zekaizer/deskhop/src-rust/src/hal/ffi/tasks.rs

// Task scheduler entry points — called from Rust scheduler in lib.rs.
// C-called FFI exports (#[no_mangle]) are at the bottom of this file.

// --- Static state ---
// DBG_COUNT and LAST_POINTER_MOVE are touched only from Core0 scheduler tasks,
// so raw static mut access via addr_of_mut! is safe.

static mut DBG_COUNT: u32 = 0;
static mut LAST_POINTER_MOVE: u32 = 0;

// --- Passthrough state ---
//
// KNOWN RACE: PT_STATE is shared mutable state accessed from BOTH cores
// without atomic protection. Writers:
//   - Core0: passthrough_task (scheduler), rust_on_tud_set_report (TinyUSB
//     device cb)
//   - Core1: rust_on_hid_mount, rust_on_hid_umount, rust_on_hid_report_received
//     (TinyUSB host callbacks)
// Readers (Core0): rust_get_*_descriptor, pt_is_active, pt_iface_count,
// pt_upstream_vid/pid (called from TinyUSB device GET_DESCRIPTOR path).
//
// This violates ADR-0002's "no contention" invariant. Race windows are narrow
// in practice (USB enumeration is the only timing-sensitive path) and the
// failure modes (torn descriptor reads, use-after-compaction) are rare but
// real. Production fix is a Core1→Core0 mount/umount/report event queue so
// PT_STATE mutation is serialized to Core0; deferred. See CONTEXT.md
// "Flagged ambiguities".

use crate::domain::passthrough::PassthroughState;

static mut PT_STATE: PassthroughState = unsafe { core::mem::zeroed() };

/// Get mutable reference to passthrough state.
/// SAFETY: Caller must accept the cross-core race documented above.
pub(crate) unsafe fn get_pt_state() -> &'static mut PassthroughState {
    &mut *core::ptr::addr_of_mut!(PT_STATE)
}

// --- Remap engine state (Core1-serialized) ---
//
// All post-boot access runs on Core1: remap_engine_process in the TinyUSB
// host report callback (inside usb_host_task) and remap_engine_tick_task,
// both on the Core1 scheduler loop, strictly sequential. The only Core0
// access is remap_engine_init in rust_passthrough_init, which runs before
// multicore_launch_core1 (setup.c). Do not schedule users of this state on
// Core0 — that reintroduces a cross-core aliased-&mut race.

use crate::domain::key_remap::RemapEngine;

static mut REMAP_ENGINE: RemapEngine = unsafe { core::mem::zeroed() };

pub(crate) unsafe fn get_remap_engine() -> &'static mut RemapEngine {
    &mut *core::ptr::addr_of_mut!(REMAP_ENGINE)
}

// ============================================================
// Scheduler task functions (Rust ABI — called from lib.rs)
// ============================================================

pub(crate) unsafe fn kick_watchdog_task() {
    let hal = crate::hal::pico::PicoHal::new();
    let mut state = crate::domain::structs::DeviceState::from_globals();
    let state = &mut state;
    crate::service::tasks::check_system_health(state, &hal);

    use crate::hal::traits::Trace;
    let count = &mut *core::ptr::addr_of_mut!(DBG_COUNT);
    *count += 1;
    if *count >= 150 {
        *count = 0;
        hal.dump_state();
    }
}

pub(crate) unsafe fn heartbeat_output_task() {
    let hal = crate::hal::pico::PicoHal::new();
    let state = crate::domain::structs::DeviceState::from_globals();
    crate::service::tasks::heartbeat_tick(&state, &hal);
}

pub(crate) unsafe fn packet_receiver_task() {
    let hal = crate::hal::pico::PicoHal::new();
    let mut state = crate::domain::structs::DeviceState::from_globals();
    crate::service::tasks::packet_receive_tick(&mut state, &hal);
}

// Core0 only (device-side scheduler task).
static mut HID_QUEUE_STALL: crate::service::tasks::HeadStall =
    crate::service::tasks::HeadStall::new();

pub(crate) unsafe fn process_hid_queue_task() {
    let hal = crate::hal::pico::PicoHal::new();
    let stall = &mut *core::ptr::addr_of_mut!(HID_QUEUE_STALL);
    crate::service::tasks::process_hid_queue(&hal, stall, crate::hal::device::hal_time_us_32());
}

pub(crate) unsafe fn led_blinking_task() {
    let hal = crate::hal::pico::PicoHal::new();
    let mut state = crate::domain::structs::DeviceState::from_globals();
    crate::service::tasks::led_blink_tick(&mut state, &hal);
}

/// Re-send the keyboard LED state until the keyboard accepts it. Core1 only:
/// send_kbd_leds_xcore reaches tuh_hid_set_report directly on this core.
pub(crate) unsafe fn led_sync_task() {
    let cfg = &*core::ptr::addr_of!(crate::domain::structs::GLOBAL_CFG);
    if let Some(desired) = crate::service::led::led_sync_needed(cfg) {
        let hid = &*core::ptr::addr_of!(crate::domain::structs::GLOBAL_HID);
        crate::hal::ffi::callbacks::send_kbd_leds_xcore(
            hid.kbd_dev_addr, hid.kbd_instance, &desired, 1,
        );
    }
}

pub(crate) unsafe fn screensaver_task() {
    let hal = crate::hal::pico::PicoHal::new();
    let mut state = crate::domain::structs::DeviceState::from_globals();
    let state = &mut state;

    let mut report_bytes = [0u8; 8];
    let role = state.cfg.board_role as usize;
    if role < state.cfg.config.output.len() {
        match state.cfg.config.output[role].screensaver.mode {
            1 => super::util::rust_screensaver_pong(report_bytes.as_mut_ptr()),
            2 => super::util::rust_screensaver_jitter(report_bytes.as_mut_ptr()),
            _ => {}
        }
    }

    let last_move = &mut *core::ptr::addr_of_mut!(LAST_POINTER_MOVE);
    if let Some(t) = crate::service::tasks::screensaver_tick(state, &hal, *last_move, &report_bytes) {
        *last_move = t;
    }
}

/// Stamp HID activity for the board-LED flicker. Called on the active board when
/// it actually sends a report to its host — so the ACTIVE board flickers even
/// when the dongle/receiver is on the other board (reports arrive via UART).
unsafe fn mark_hid_activity() {
    let cfg = &mut *core::ptr::addr_of_mut!(crate::domain::structs::GLOBAL_CFG);
    cfg.last_hid_activity_us = crate::hal::device::hal_time_us_32();
}

pub(crate) unsafe fn process_kbd_queue_task() {
    let hal = crate::hal::pico::PicoHal::new();
    let state = crate::domain::structs::DeviceState::from_globals();
    if crate::service::backend::host_link::send_pending_kbd(&state, &hal) {
        mark_hid_activity();
    }
}

pub(crate) unsafe fn process_mouse_queue_task() {
    let hal = crate::hal::pico::PicoHal::new();
    let state = crate::domain::structs::DeviceState::from_globals();
    if crate::service::backend::host_link::send_pending_mouse(&state, &hal) {
        mark_hid_activity();
    }
}

pub(crate) unsafe fn process_uart_tx_task() {
    let hal = crate::hal::pico::PicoHal::new();
    crate::service::tasks::flush_outbox(&hal);
}

pub(crate) unsafe fn debug_log_flush_task() {
    crate::service::peer_log::debug_log_flush_task();
}

pub(crate) unsafe fn passthrough_task() {
    let hal = crate::hal::pico::PicoHal::new();
    let mut state = crate::domain::structs::DeviceState::from_globals();
    let pt = get_pt_state();
    crate::service::passthrough_service::passthrough_task(pt, &mut state, &hal);
}

/// Core1 task: flush the pending HID++ output report to the upstream device.
/// Runs on Core1 so the host control transfer is serialized with tuh_task;
/// see passthrough_service::flush_output_report for why this must not be Core0.
pub(crate) unsafe fn passthrough_host_tx_task() {
    let hal = crate::hal::pico::PicoHal::new();
    let pt = get_pt_state();
    crate::service::passthrough_service::flush_output_report(pt, &hal);
}

pub(crate) unsafe fn remap_engine_tick_task() {
    let hal = crate::hal::pico::PicoHal::new();
    let mut state = crate::domain::structs::DeviceState::from_globals();
    let state = &mut state;
    use crate::hal::traits::Timer;
    let now = hal.now_us_64();
    let engine = get_remap_engine();
    use crate::domain::key_remap;
    let hold_entered = key_remap::remap_engine_tick(engine, now);

    let mut pending = crate::domain::structs::HidKeyboardReport::default();
    if key_remap::remap_engine_get_pending(engine, &mut pending) {
        let mut tap_press = crate::domain::kbd_state::combine_kbd_states(state);
        for k in tap_press.keycode.iter_mut() {
            if *k == 0 {
                *k = pending.keycode[0];
                break;
            }
        }
        tap_press.modifier |= pending.modifier;
        use crate::service::router::ReportRouter;
        let report_bytes: [u8; 8] = core::mem::transmute(tap_press);
        hal.route_kbd(state, &report_bytes);
        let release = crate::domain::kbd_state::combine_kbd_states(state);
        let release_bytes: [u8; 8] = core::mem::transmute(release);
        hal.route_kbd(state, &release_bytes);
    }

    if hold_entered {
        // Inject the hold-action keys (e.g. CapsLock) of entries that just
        // entered Held — without this the hold produces nothing on the host.
        let mut combined = crate::domain::kbd_state::combine_kbd_states(state);
        let mut hold = crate::domain::structs::HidKeyboardReport::default();
        key_remap::remap_engine_get_active_output(engine, &mut hold);
        for &hk in hold.keycode.iter() {
            if hk == 0 {
                continue;
            }
            for k in combined.keycode.iter_mut() {
                if *k == 0 {
                    *k = hk;
                    break;
                }
            }
        }
        combined.modifier |= hold.modifier;
        use crate::service::router::ReportRouter;
        let bytes: [u8; 8] = core::mem::transmute(combined);
        hal.route_kbd(state, &bytes);
    }
}

// ============================================================
// C-callable FFI exports (#[no_mangle] / #[export_name])
// ============================================================

/// Called from C initial_setup to init remap engine + apply gaming_mode_default.
#[no_mangle]
pub unsafe extern "C" fn rust_passthrough_init() {
    let state = crate::domain::structs::DeviceState::from_globals();
    let os_a = state.cfg.config.output[0].os;
    let os_b = state.cfg.config.output[1].os;
    let engine = get_remap_engine();
    crate::domain::key_remap::remap_engine_init(engine, os_a, os_b);
    let cfg = &mut *core::ptr::addr_of_mut!(crate::domain::structs::GLOBAL_CFG);
    cfg.gaming_mode = cfg.config.gaming_mode_default != 0;
}

// --- FW auto-sync stall recovery (Core1 only: fw-upgrade receiver task) ---

use crate::service::fw_upgrade::{StallAction, StallTracker};

static mut FW_STALL: StallTracker = StallTracker::new();

/// Called from firmware_upgrade_task_c while waiting for a ResponseByte
/// (`upgrade_in_progress && !byte_done`). Returns nonzero when the caller
/// should re-send the RequestByte for the current address. An abort is
/// applied here (clears upgrade_in_progress) so heartbeats resume and the
/// peer restarts the sync from scratch.
#[no_mangle]
pub unsafe extern "C" fn rust_fw_stall_tick() -> u32 {
    let tracker = &mut *core::ptr::addr_of_mut!(FW_STALL);
    let state = crate::domain::structs::DeviceState::from_globals();
    let address = state.fw.fw.address;
    let now = crate::hal::device::hal_time_us_32();
    match crate::service::fw_upgrade::stall_tick(tracker, address, now) {
        StallAction::None => 0,
        StallAction::Resend => {
            crate::service::dlog::w(b"fw")
                .s(b"rx stall resend addr=").u(address).done();
            1
        }
        StallAction::Abort => {
            crate::service::dlog::e(b"fw")
                .s(b"rx stall ABORT addr=").u(address).done();
            state.fw.fw.upgrade_in_progress = false;
            state.fw.fw.address = 0;
            0
        }
    }
}

/// Called from C set_active_output / Rust callbacks.
#[export_name = "release_all_keys"]
pub unsafe extern "C" fn rust_release_all_keys() {
    let hal = crate::hal::pico::PicoHal::new();
    let mut state = crate::domain::structs::DeviceState::from_globals();
    crate::service::backend::host_link::release_all_keys(&mut state, &hal);
}

// --- Passthrough state accessors for C (usb_descriptors.c) ---

#[no_mangle]
pub unsafe extern "C" fn pt_is_active() -> bool {
    (*core::ptr::addr_of!(PT_STATE)).active
}

#[no_mangle]
pub unsafe extern "C" fn pt_iface_count() -> u8 {
    (*core::ptr::addr_of!(PT_STATE)).iface_count
}

#[no_mangle]
pub unsafe extern "C" fn pt_upstream_vid() -> u16 {
    (*core::ptr::addr_of!(PT_STATE)).upstream_vid
}

#[no_mangle]
pub unsafe extern "C" fn pt_upstream_pid() -> u16 {
    (*core::ptr::addr_of!(PT_STATE)).upstream_pid
}

#[no_mangle]
pub unsafe extern "C" fn pt_config_desc(out_len: *mut u16) -> *const u8 {
    let (ptr, len) = super::pt_config_desc_ptr();
    if !out_len.is_null() { *out_len = len; }
    ptr
}

#[no_mangle]
pub unsafe extern "C" fn pt_get_report_desc(device_instance: u8, out_len: *mut u16) -> *const u8 {
    let pt = &*core::ptr::addr_of!(PT_STATE);
    match crate::domain::passthrough::get_report_desc(pt, device_instance) {
        Some((desc, len)) => {
            if !out_len.is_null() { *out_len = len; }
            desc.as_ptr()
        }
        None => core::ptr::null(),
    }
}

// pt_iface_protocol / pt_iface_desc_len (C accessors for the old C descriptor
// builder) were removed: the builder is now Rust (domain::usb_config_desc) and
// reads PT_STATE directly via get_pt_state.
