zekaizer/deskhop/src-rust/src/domain/keyboard.rs

use crate::domain::structs::HidKeyboardReport;

/// What action to perform when a hotkey matches
#[derive(Debug, Clone, Copy, PartialEq, Eq)]
pub enum HotkeyAction {
    OutputToggle,
    MouseZoomToggle,
    SwitchLockToggle,
    ScreenLock,
    GamingModeToggle,
    ScreensaverPong,
    ScreensaverJitter,
    ScreensaverDisable,
    WipeConfig,
    ScreenBorder,
    ConfigEnable,
    FwUpgradeA,
    FwUpgradeB,
}

impl HotkeyAction {
    /// Short name for debug logging.
    pub const fn name(&self) -> &'static [u8] {
        match self {
            Self::OutputToggle => b"OutputToggle",
            Self::MouseZoomToggle => b"MouseZoomToggle",
            Self::SwitchLockToggle => b"SwitchLockToggle",
            Self::ScreenLock => b"ScreenLock",
            Self::GamingModeToggle => b"GamingModeToggle",
            Self::ScreensaverPong => b"ScreensaverPong",
            Self::ScreensaverJitter => b"ScreensaverJitter",
            Self::ScreensaverDisable => b"ScreensaverDisable",
            Self::WipeConfig => b"WipeConfig",
            Self::ScreenBorder => b"ScreenBorder",
            Self::ConfigEnable => b"ConfigEnable",
            Self::FwUpgradeA => b"FwUpgradeA",
            Self::FwUpgradeB => b"FwUpgradeB",
        }
    }
}

/// Hotkey definition for matching keyboard combos
pub struct HotkeyCombo {
    pub modifier: u8,
    pub keys: &'static [u8],
    pub pass_to_os: bool,
    pub acknowledge: bool,
    pub action: HotkeyAction,
}

/// Result of check_all_hotkeys
pub struct HotkeyMatch {
    pub action: HotkeyAction,
    pub pass_to_os: bool,
    pub acknowledge: bool,
}

/// Check all hotkeys against a report. Returns first match.
pub fn check_all_hotkeys(report: &HidKeyboardReport) -> Option<HotkeyMatch> {
    use crate::domain::constants::*;

    static HOTKEYS: &[HotkeyCombo] = &[
        HotkeyCombo { modifier: HOTKEY_MODIFIER, keys: &[HOTKEY_TOGGLE], pass_to_os: false, acknowledge: false, action: HotkeyAction::OutputToggle },
        HotkeyCombo { modifier: KEYBOARD_MODIFIER_RIGHTALT | KEYBOARD_MODIFIER_RIGHTCTRL, keys: &[], pass_to_os: true, acknowledge: true, action: HotkeyAction::MouseZoomToggle },
        HotkeyCombo { modifier: KEYBOARD_MODIFIER_RIGHTCTRL, keys: &[HID_KEY_K], pass_to_os: false, acknowledge: true, action: HotkeyAction::SwitchLockToggle },
        HotkeyCombo { modifier: KEYBOARD_MODIFIER_RIGHTCTRL, keys: &[HID_KEY_L], pass_to_os: false, acknowledge: true, action: HotkeyAction::ScreenLock },
        HotkeyCombo { modifier: KEYBOARD_MODIFIER_LEFTCTRL | KEYBOARD_MODIFIER_RIGHTSHIFT, keys: &[HID_KEY_G], pass_to_os: false, acknowledge: true, action: HotkeyAction::GamingModeToggle },
        HotkeyCombo { modifier: KEYBOARD_MODIFIER_LEFTCTRL | KEYBOARD_MODIFIER_RIGHTSHIFT, keys: &[HID_KEY_S], pass_to_os: false, acknowledge: true, action: HotkeyAction::ScreensaverPong },
        HotkeyCombo { modifier: KEYBOARD_MODIFIER_LEFTCTRL | KEYBOARD_MODIFIER_RIGHTSHIFT, keys: &[HID_KEY_J], pass_to_os: false, acknowledge: true, action: HotkeyAction::ScreensaverJitter },
        HotkeyCombo { modifier: KEYBOARD_MODIFIER_LEFTCTRL | KEYBOARD_MODIFIER_RIGHTSHIFT, keys: &[HID_KEY_X], pass_to_os: false, acknowledge: true, action: HotkeyAction::ScreensaverDisable },
        HotkeyCombo { modifier: KEYBOARD_MODIFIER_RIGHTSHIFT, keys: &[HID_KEY_F12, HID_KEY_D], pass_to_os: false, acknowledge: true, action: HotkeyAction::WipeConfig },
        HotkeyCombo { modifier: KEYBOARD_MODIFIER_RIGHTSHIFT, keys: &[HID_KEY_F12, HID_KEY_Y], pass_to_os: false, acknowledge: true, action: HotkeyAction::ScreenBorder },
        HotkeyCombo { modifier: KEYBOARD_MODIFIER_LEFTCTRL | KEYBOARD_MODIFIER_RIGHTSHIFT, keys: &[HID_KEY_C, HID_KEY_O], pass_to_os: false, acknowledge: true, action: HotkeyAction::ConfigEnable },
        HotkeyCombo { modifier: KEYBOARD_MODIFIER_RIGHTSHIFT | KEYBOARD_MODIFIER_LEFTSHIFT, keys: &[HID_KEY_A], pass_to_os: false, acknowledge: true, action: HotkeyAction::FwUpgradeA },
        HotkeyCombo { modifier: KEYBOARD_MODIFIER_RIGHTSHIFT | KEYBOARD_MODIFIER_LEFTSHIFT, keys: &[HID_KEY_B], pass_to_os: false, acknowledge: true, action: HotkeyAction::FwUpgradeB },
    ];

    for hotkey in HOTKEYS {
        if check_specific_hotkey(hotkey, report) {
            return Some(HotkeyMatch {
                action: hotkey.action,
                pass_to_os: hotkey.pass_to_os,
                acknowledge: hotkey.acknowledge,
            });
        }
    }
    None
}

/// Check if a key exists in a keyboard report.
// WORKAROUND(c-compat): Matches C behavior where key=0x00 returns true
// because empty slots contain 0x00. Could filter key==0 in the future.
pub fn key_in_report(key: u8, report: &HidKeyboardReport) -> bool {
    report.keycode.contains(&key)
}

/// Check if a keyboard report matches a specific hotkey combo
pub fn check_specific_hotkey(hotkey: &HotkeyCombo, report: &HidKeyboardReport) -> bool {
    // All specified modifiers must be present
    if hotkey.modifier != (report.modifier & hotkey.modifier) {
        return false;
    }

    // All specified keys must be present
    hotkey.keys.iter().all(|&key| key_in_report(key, report))
}

/// Add keys from src to dest, skipping zeros and duplicates.
/// Returns how many keys were added.
pub fn add_keys(dest: &mut HidKeyboardReport, src: &HidKeyboardReport) -> usize {
    let mut added = 0;

    for &key in &src.keycode {
        if key == 0 || key_in_report(key, dest) {
            continue;
        }

        // Find first empty slot
        if let Some(slot) = dest.keycode.iter_mut().find(|k| **k == 0) {
            *slot = key;
            added += 1;
        }
    }

    added
}

/// Combine multiple keyboard reports into one, merging modifiers and keys.
pub fn combine_reports(reports: &[HidKeyboardReport]) -> HidKeyboardReport {
    let mut combined = HidKeyboardReport::default();

    for report in reports {
        combined.modifier |= report.modifier;
        add_keys(&mut combined, report);
    }

    combined
}
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
