zekaizer/deskhop/(commit log)

2026-03-18 test: add Unity framework and placeholder test
2026-03-18 ci(test): add unit test workflow with Unity framework
2026-03-18 feat(passthrough): hook descriptor capture into mount callback
2026-03-18 fix(passthrough): add missing passthrough_get_state declaration
    [passthrough.h]
2026-03-18 fix(passthrough): add unmount cleanup and duplicate capture prevention
    [passthrough.c, passthrough.h, usb.c]
2026-03-18 refactor(passthrough): cache passthrough_get_state() in mount callback
2026-03-19 docs: add Bolt receiver HID descriptor capture from real hardware
    Captured via passthrough_dump_descriptors() on DeskHop PCB v1.1.
    Documents all 3 interfaces (Keyboard, Mouse, HID++ Vendor) with
    parsed field descriptions and report ID mappings.
2026-03-19 docs(spec): add conditional VID/PID switching design (FR-PT-009, FR-PT-010)
    TECHSTACK: add VID/PID switching flow to Phase 2 passthrough design.
    SSR: add FR-PT-009 (upstream VID/PID exposure) and FR-PT-010 (unmount
    revert). Update FR-PT-005 acceptance criteria for Options+ recognition.
2026-03-19 feat(passthrough): add device-side descriptor generation and instance mapping
    Build dynamic USB configuration descriptor combining DeskHop's own
    interfaces (ITF 0-1) with passthrough interfaces captured from the host
    device. Includes host↔device instance mapping for report routing and
    modified TinyUSB callbacks to serve passthrough descriptors.
2026-03-19 feat(passthrough): add raw report forwarding for passthrough interfaces
    Forward non-keyboard input reports from host receiver to device-side
    passthrough interfaces (mouse raw, vendor/HID++). Forward output reports
    (SET_REPORT from Win11/Options+) back to the host receiver. Keyboard
    reports continue through DeskHop's parsing pipeline for hotkey detection.
2026-03-19 feat(passthrough): add re-enumeration task for passthrough activation
    Add periodic passthrough_task on core0 that detects when host descriptor
    capture stabilizes (500ms after last capture), builds the device-side
    configuration descriptor, and triggers USB re-enumeration via
    tud_disconnect/tud_connect with 200ms delay per USB spec.
2026-03-19 fix(debug): add timestamps and reduce log noise
    - Prepend [ms] timestamp to all dh_debug_printf output
    - Only log HID++ vendor IN reports (skip high-frequency mouse)
    - Add passthrough task lifecycle logs (activate/disconnect/reconnect)
    [tasks.c, usb.c]
2026-03-19 feat(passthrough): conditional VID/PID switching for Options+ (FR-PT-009)
    - Capture upstream VID/PID via tuh_vid_pid_get() on mount
    - Return upstream VID/PID in tud_descriptor_device_cb() when active
    - Override manufacturer/product strings for Logitech VID (0x046D)
    - Clear VID/PID and re-enumerate on unmount (FR-PT-010)
    - Add unit tests for VID/PID capture, clear, and retention
2026-03-19 feat(passthrough): deferred HID++ output via raw SET_REPORT
    Queue HID++ output reports from device callback and send via
    tuh_control_xfer in passthrough_task. Logitech receivers require
    full report (report_id + payload) in the data phase with wLength
    matching the full report size, not TinyUSB's default behavior.
2026-03-19 fix(passthrough): always re-queue receive for always_passthrough interfaces
    HID++ vendor interface must call tuh_hid_receive_report() regardless
    of active output, otherwise IN reports stop after the first few.
    Also queue output reports for deferred send instead of direct
    tuh_hid_set_report from callback, and add debug logging.
    [usb.c]
2026-03-19 docs: add HID++ output report protocol analysis
    Documents SET_REPORT wire format for Logitech receivers, Linux kernel
    driver behavior, and the wLength=7 requirement discovered during
    real hardware testing.
2026-03-19 feat(passthrough): classify HID++ messages by sw_id, drop input events on inactive output
    HID++ vendor interface (always_passthrough) now routes by message type:
    - sw_id != 0: protocol response → always forward to device side (Options+)
    - sw_id == 0: unsolicited input event → forward only to active output
    - B active: input events dropped (P3 will convert to standard HID via UART)
    Fixes issue where HiRes scroll and side buttons acted on output A when B was active.
    [passthrough.c, passthrough.h, usb.c]
2026-03-19 refactor(passthrough): address code review findings
    - Fix potential buffer overflow: MAX_CONFIG_DESC_SIZE 256→280 + bounds check
    - Remove epout probe that sent dummy data to device on mount
    - Delegate to TUD_HID_DESCRIPTOR / TUD_CDC_DESCRIPTOR macros instead of
    manual byte construction (eliminates drift risk, -80 lines)
    - Remove duplicate VID/PID clearing in tuh_hid_umount_cb
    - Replace magic 0x09 with HID_REQ_CONTROL_SET_REPORT constant
    - Consolidate triplicated tuh_hid_receive_report into single call site
    - Guard hex dump in tud_hid_set_report_cb with #ifdef DH_DEBUG
    [passthrough.h, tasks.c, usb.c]
2026-03-19 docs(spec): reflect P2 HID++ discoveries in TECHSTACK and SSR
    TECHSTACK.md:
    - §3.2: routing table split HID++ vendor into protocol (sw_id≠0) vs
    input events (sw_id=0), update Android-mode diagram with sw_id branch
    - §3.2: output report path corrected to tuh_control_xfer (not
    tuh_hid_set_report which STALLs on Logitech receivers)
    - §3.3: passthrough_state_t updated to match actual implementation
    (out_queue, VID/PID, config_desc, timestamps)
    - §3.4 Phase 3: replaced planned design with actual implementation
    results, add HID++ message structure and feature index table
    SSR.md:
    - FR-AO-004: add sw_id classification to routing description
    - Appendix A.1: update data structures to ma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
2026-03-20 chore: add clangd setup for cross-compilation IDE support
    - .clangd config with diagnostics settings
    - .vscode/settings.json with --query-driver for arm-none-eabi
    - .gitignore: compile_commands.json, .cache
2026-03-20 feat(passthrough): IRoot feature discovery and HID++ to mouse conversion
    IRoot Discovery Engine:
    - State machine in passthrough_task: IDLE → DETECT_DEVICE →
    QUERY_HIRES_SCROLL → QUERY_THUMBWHEEL → DONE
    - Detects HID++ device index from first vendor interface traffic
    - Sends IRoot queries via out_queue (sw_id=0x0F)
    - Intercepts responses, caches feature indices; 2s timeout per query
    HID++ → mouse_report_t Conversion:
    - Replaces silent drop with mouse report conversion on inactive output
    - HiRes Scroll (0x2121) → wheel, Thumbwheel (0x2150) → pan
    - Uses output_mouse_report() for automatic UART relay
    - Unknown features still dropped gracefully
    Tests: IRoot response parsing, HiR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
    [passthrough.c, passthrough.h, tasks.c, usb.c]
2026-03-20 wip(passthrough): HID++ button conversion, auto-learn, debug tools
    - Auto-learn ReprogControls feature index from observed events (bypass IRoot)
    - analyticsKeyEvent (fn=2) parsing with button state tracking
    - Merge HID++ button_state into output_mouse_report (B active only)
    - Immediate button report with cursor position on state change
    - Clear passthrough state on device disconnect (active, button_state)
    - Clear button_state on output switch
    - HID++ protocol scan hotkey (LeftCtrl+RightShift+H+P)
    - Pipeline debug hotkey (LeftCtrl+RightShift+P+D) with P1-P5 trace
    - Raw HID++ event hex dump toggle
    - BOOTSEL short press output switch (core1→core0 flag)
    NOTE: Button click not yet functional on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
    [passthrough.c, passthrough.h, pinout.h, structs.h, tasks.c, usb.c]
2026-03-20 fix(passthrough): P3 immediate button report respects gaming/relative mode
    The HID++ button-change immediate report (P3) was hardcoded to ABSOLUTE
    mode, causing two issues:
    1. In gaming mode, buttons were sent to Interface 0 (ABS) while movement
    went to Interface 1 (REL), resulting in duplicate button delivery on
    both USB interfaces.
    2. In relative mode, absolute pointer coordinates were sent as relative
    deltas, causing cursor teleportation on button press/release.
    Fix: check gaming_mode/relative_mouse and set mode accordingly. In
    relative mode, send zero coordinates (button-only, no movement).
    [usb.c]
2026-03-20 chore: reduce verbose passthrough debug logs
    Suppress high-frequency success logs for OUT raw xfer and SET_REPORT
    callbacks. Only log on failure to keep CDC debug output readable.
    [tasks.c]
2026-03-20 docs: add HID++ protocol analysis for Bolt receiver
    Add observed feature index map, button CIDs, HiResScroll/Thumbwheel
    event formats, and Options+ impact analysis captured from debug logs.
    Documents the root cause of wheel loss after Options+ detection.
2026-03-20 fix(passthrough): HID++ wheel conversion mode and struct packing
    Fix two bugs preventing HiResScroll/Thumbwheel HID++ events from
    reaching Android after Options+ diverts wheel reporting to HID++:
    1. passthrough_mouse_report_t missing TU_ATTR_PACKED — struct padding
    mismatch with mouse_report_t caused wheel/pan values to be written
    at wrong offsets (offset 6 vs expected 5 on ARM).
    2. Converted wheel reports sent with mode=ABSOLUTE (default 0) instead
    of RELATIVE — Android ignores ABSOLUTE interface when gaming_mode
    is active. Now matches button conversion which correctly sets mode.
    [passthrough.c, usb.c]
2026-03-20 feat(passthrough): passive HID++ feature discovery via host command sniffing
    Instead of sending IRoot queries (which compete with Options+ for the
    out_queue), sniff the host's own setup commands as they pass through:
    - HiResScroll: detected from setWheelMode(fn=2, param=0x03) signature
    - Thumbwheel: detected from setReporting(fn=2, param=0x01) with
    same-device guard to prevent false positives
    Options+ uses FeatureSet (not IRoot) for enumeration, making our
    previous IRoot-based passive sniffing ineffective. The command
    signature approach works regardless of discovery protocol used by
    the host software.
    [passthrough.h, usb.c]
2026-03-20 feat(passthrough): discovery-first connect with LED status indication
    Defer tud_connect() until passthrough descriptor is ready, eliminating
    the disconnect/reconnect cycle that caused a brief device "blink" on
    the host side.
    Boot flow: tud_init() → tud_disconnect() → wait for descriptor
    capture → passthrough_activate() → tud_connect() (single connect).
    Fallback: 3s timeout with no receiver → connect with defaults.
    LED slow pulse (50ms on / 450ms off) indicates passthrough preparation
    in progress, distinct from config mode's fast burst pattern.
2026-03-20 chore: remove verbose passthrough descriptor dump on mount
    The per-interface hex dump fired on every tuh_hid_mount_cb() call,
    producing 3 large log blocks for each Bolt receiver enumeration.
    No longer needed after passthrough stabilization.
    [usb.c]
2026-03-20 fix(passthrough): unconditionally set device_idx on setWheelMode sniff
    setWheelMode(0x03) is unique to HiResScroll and definitively identifies
    the mouse device. Always update device_idx instead of only when zero,
    fixing Thumbwheel false positive when active IRoot discovery previously
    set device_idx to the keyboard.
    [usb.c]
2026-03-20 refactor(passthrough): remove active IRoot discovery in favor of passive sniffing
    Active IRoot queries competed with Options+ for the single-entry
    out_queue and incorrectly set device_idx to the keyboard. Passive
    sniffing of host setup commands (setWheelMode, setReporting) is
    reliable and zero-cost.
2026-03-20 fix(passthrough): skip passthrough in config mode to prevent ITF collision
    ITF_NUM_PT_BASE and ITF_NUM_HID_VENDOR are both 2, causing passthrough
    to intercept config mode's vendor HID SET_REPORT and INPUT forwarding.
    Fix: skip passthrough_task() entirely in config mode, and add safety
    guards on both SET_REPORT and INPUT passthrough entry points.
    [setup.c, tasks.c, usb.c]
2026-03-20 chore: remove dead IRoot discovery code, clean up structs
    Remove active IRoot discovery functions and state (replaced by passive
    sniffing in 16df064). Clean up:
    - passthrough.h: remove DISC_* enum values, state/query_sent_us fields,
    send/handle/step function declarations, unused HIDPP_DISC_TIMEOUT_US
    - passthrough.c: remove ~120 lines of IRoot query/response/step code
    - passthrough.c: reset all fi_* fields on device removal
    - structs.h: move LED_BLINK defines outside struct body
    - tests: remove test_iroot_response_parsing, update remaining tests
    [passthrough.c, passthrough.h, structs.h, usb.c]
2026-03-20 fix(passthrough): normalize HiRes scroll speed with accumulator
    HiRes mode: ~6-7 events/notch × delta~2 = ~12-14 total per notch.
    Normal mode: 1 event × delta=1 = 1 per notch.
    Accumulate HiRes deltas and divide by 12 to normalize to standard
    wheel behavior. Applies to both vertical and horizontal scroll.
    [passthrough.c, passthrough.h]
2026-03-20 feat(passthrough): SmartShift button (CID 0xC4) as A/B output switch
    Intercept HID++ analyticsKeyEvent for CID 0x00C4 before output routing,
    so it works regardless of which output is active. Event is forwarded
    (not consumed) to keep Options+ in sync.
    Ratchet mode is managed via Options+ SmartShift button assignment
    (set to "None" to prevent physical toggle).
    [passthrough.c, structs.h, tasks.c, usb.c]
2026-03-20 feat(remap): integrate remap engine into firmware
    Add remap_engine to device_t, hook into keyboard callback,
    add 1ms tick task for tap-hold timeout.
2026-03-20 fix(remap): correct keyboard pipeline ordering for remap engine
    The remap engine was not effective because:
    1. remap_engine_init() was never called at boot
    2. send_key() uses combine_kbd_states() which reads cached keyboard
    state — remap modified the report but not the cache
    Fix pipeline ordering:
    extract → update_state → check_hotkeys (original keys)
    → remap → update_state again (remapped keys) → send_key
    Hotkeys match on original physical keys (e.g., Ctrl+CapsLock),
    while the host receives remapped keys (e.g., LShift+Space).
    [setup.c]
2026-03-21 feat(remap): require double-click on SmartShift for output switch
2026-03-22 fix(remap): deliver TAP_HOLD tap and hold actions to host
    send_key() ignores its report argument and always uses
    combine_kbd_states(), which only combines local_kbd_states.
    TAP_HOLD removes the trigger from reports, so neither tap
    (via get_pending) nor hold actions ever reached the host.
    - Add remap_engine_get_active_output() to expose RS_HELD keys
    - Include active output in combine_kbd_states() for hold delivery
    - Route tap actions directly via route_kbd_report() helper
    - Return bool from remap_engine_tick() to trigger hold send
    - Update tick_task to send combined report on hold transition
    [key_remap.c, key_remap.h, tasks.c]
2026-03-22 feat(remap): skip CapsLock TAP_HOLD on macOS outputs
    macOS handles CapsLock → 한영 natively, so applying the
    TAP_HOLD remap causes double-switching. Use OUTPUT_A_OS /
    OUTPUT_B_OS config to compute output_mask at init time,
    excluding macOS outputs from the default CapsLock entry.
    - Add os_a/os_b params to remap_engine_init()
    - Pass runtime config values from setup.c
    - Add os_type_e mirror enum for unit test builds
    [key_remap.c, key_remap.h, setup.c]
2026-03-22 chore(remap): increase TAP_HOLD default threshold to 250ms
    200ms felt too short for comfortable tap-vs-hold distinction.
    [key_remap.h]
2026-03-22 feat(config): gate passthrough on PASSTHROUGH_ENABLED flag
    Skip descriptor capture and passthrough activation when
    PASSTHROUGH_ENABLED=0. BOOTSEL and SmartShift button handling
    remain active regardless. Logitech receivers (Bolt/Unifying)
    auto-detected by VID when enabled.
    [tasks.c, usb.c]
2026-03-22 feat(config): add Semi-DDM fields to config_t for runtime settings
    Add passthrough_enabled, gaming_mode_default, and
    smartshift_double_click_us to config_t with flash persistence.
    Bump CURRENT_CONFIG_VERSION to 9. Replace compile-time macros
    with runtime config references in tasks.c, usb.c, and setup.c.
    Add api_field_map entries (90-92) for webconfig access.
    [config.h, setup.c, structs.h, tasks.c, usb.c]
2026-03-22 refactor(config): change SmartShift threshold unit from μs to ms
    More intuitive for webconfig UI. Config stores milliseconds,
    firmware converts to μs at comparison time (× 1000).
2026-03-22 docs: update CLAUDE.md with webconfig build pipeline and receiver info
    Add webconfig section documenting the full build pipeline
    (form.py → render.py → config.htm → disk.img → firmware),
    including sudo-free Python FAT12 image generator and
    step-by-step guide for adding new config fields.
    Update receiver info to include Unifying support.
2026-03-22 Add rust_main_loop() FFI call in main.c
    Call the Rust entry point after initial_setup(). Currently a no-op
    stub that returns immediately, so no behavioral change.
    Verified: rust_main_loop symbol linked at 0x2000ef8c.
2026-03-22 Add trace macro infrastructure with feature-gated UART output
    trace!() and traceln!() macros write raw bytes to UART via C HAL
    shim when `trace` feature is enabled. Compiles to zero code in
    release builds without the feature. DH_DEBUG integration to follow.
2026-03-22 Port UART packet struct and serialization to Rust
    Add packet module with UartPacket struct, write_raw_packet(),
    parse_raw_packet(), checksum verification, and ring buffer pointer
    delta calculation. 6 unit tests covering roundtrip, bad preamble,
    checksum, and data accessors.
2026-03-22 Port mouse coordinate math and acceleration to Rust
    Add mouse module with move_and_keep_on_screen(), screen switch
    detection, acceleration factor calculation (alpha-max-beta-min
    instead of sqrtf to avoid libm), and Y-coordinate scaling for
    cross-screen transitions. 12 unit tests.
    [lib.rs, mouse.rs]
2026-03-22 Port keyboard hotkey matching and report merging to Rust
    Add keyboard module with KeyboardReport struct, key_in_report(),
    check_specific_hotkey(), add_keys() with dedup, and
    combine_reports() for multi-device keyboard state merging.
    9 unit tests covering hotkey matching, modifier handling, key
    dedup, overflow, and report combination.
2026-03-22 Annotate C-compat workarounds with WORKAROUND(c-compat) comments
    Mark 5 locations where Rust code intentionally matches C behavior
    for compatibility: key_in_report 0x00 matching, i32 return instead
    of enum, alpha-max-beta-min sqrt approximation, repr(C,packed)
    packet layout, and 1-bit sign extension semantics.
    [hid_report.rs, keyboard.rs, mouse.rs, packet.rs]
2026-03-22 Add device_t opaque handle and C HAL shim layer
    Introduce DeviceHandle as an opaque pointer to C's device_t,
    with extern "C" getter/setter functions for safe FFI access.
    Add hal_shim.c implementing all accessors (state, config, flags,
    queues, hardware). This avoids mirroring the full device_t layout
    in Rust while providing type-safe access to its fields.
    Also adds hal_trace_write() for Rust trace macro UART output.
    [device.rs, hal_shim.c, lib.rs]
2026-03-22 Activate Rust core0 main loop scheduler
    Replace C's core0 while(true) task loop with Rust's
    rust_main_loop(). The function now takes a device_t* and never
    returns. Task scheduling is identical: same 6 tasks at same
    frequencies. C main() now calls rust_main_loop(device) after
    initial_setup().
    Core1 main loop remains in C (core1_main).
    [lib.rs, main.c]
2026-03-22 Port USB callback logic to Rust (device index, bounds, LED state)
    Add usb module with calculate_device_idx() for HID report routing,
    validate_device_bounds() for addr/instance validation, and
    process_led_state() for caps lock indicator override.
    TinyUSB callbacks remain as C shims — these functions extract the
    pure logic that can be called from C. 8 unit tests.
2026-03-22 Port screensaver logic (pong, jitter, activation) to Rust
    Add screensaver module with PongState (wall bouncing), JitterState
    (alternating relative movement), Mode enum with delay_us(), and
    should_activate() for idle/timeout/connectivity checks.
    10 unit tests covering bounds, alternation, activation conditions.
    [lib.rs, screensaver.rs]
2026-03-22 Mirror core C structs in Rust (device_t, config_t, hid_interface_t)
    Add structs module with #[repr(C)] definitions for Device, Config,
    Output, BorderSize, Screensaver, FwUpgradeState, HidInterface,
    KeyboardDescriptor, MouseDescriptor, HidKeyboardReport, MouseReportC,
    UartPacketC, HidGenericPkt, FirmwareMetadata, and QueueOpaque.
    These maintain exact C layout compatibility for direct FFI access,
    replacing the opaque pointer approach for core structs.
    4 unit tests verifying struct sizes.
2026-03-22 Fix queue_t size to 16 bytes with static_assert verification
    queue_t = lock_core_t(4) + uint8_t*(4) + 4*uint16_t(8) = 16 bytes.
    Add _Static_assert in hal_shim.c to catch future SDK changes.
    [hal_shim.c, structs.rs]
2026-03-22 Port complete HID descriptor parser to Rust
    Add full ParserState with parse_descriptor() that processes HID
    report descriptors into ReportVal structures. Handles global/local/
    main items, collection tracking, report ID management, usage
    arrays, and 1-bit variable size swapping (NKRO optimization).
    Uses alloc-free ParseResults storage (no heap allocation).
    5 new tests including real mouse descriptor parsing, collection
    tracking, report ID handling, and empty descriptor edge case.
    [hid_parser.rs]
2026-03-22 Port UART packet dispatch to Rust with type-safe action mapping
    Add dispatch module with validate_received_packet() (checksum +
    type validation), DispatchAction enum for all 23 packet types,
    and process_packet() combining validation + dispatch.
    Replaces C's linear search handler table with Rust match.
    6 unit tests covering valid/invalid packets and exhaustive type mapping.
    [dispatch.rs, lib.rs]
2026-03-22 Port mouse report processing and screen switch logic to Rust
    Add mouse_logic module with update_mouse_position() (acceleration
    + clamping + switch detection), create_mouse_report() (absolute/
    relative mode), and decide_screen_switch() (lock/gaming/button/
    virtual desktop logic). Uses SwitchDirection and ScreenSwitchAction
    enums for type-safe screen transition decisions.
    9 unit tests covering movement, switching, blocking, and virtual desktops.
2026-03-22 Replace C checksum/CRC/validate with Rust FFI exports
    Export rust_calc_checksum, rust_calc_crc32, rust_crc32_iter,
    rust_verify_checksum, and rust_validate_packet as extern "C".
    C utils.c now calls Rust implementations through thin wrappers.
    This is the first actual C→Rust code replacement (not just
    parallel implementation). 7 Rust symbols actively linked.
    RAM delta: -1,024 bytes from removed C implementation code.
    [constants.rs, crc.rs]
2026-03-22 Separate FFI exports from internal modules, remove C CRC32 table
    Introduce ffi.rs as the single FFI boundary module — all
    #[no_mangle] pub extern "C" exports live here. Internal modules
    (crc, constants, etc.) no longer export FFI symbols directly.
    lib.rs now has clear layering comments:
    - Internal modules (Rust-only logic)
    - HAL layer (C↔Rust boundary: device, ffi, scheduler, trace)
    Remove CRC32 lookup table from C constants.c and flash.h extern
    declaration — table is now internal to Rust crc module, accessed
    only through rust_crc32_iter/rust_calc_crc32 FFI exports.
    [constants.rs, crc.rs, ffi.rs, flash.h, lib.rs]
2026-03-22 Reorganize Rust modules into app/ and hal/ directories
    Move pure logic modules into app/ (constants, crc, dispatch,
    handlers, hid_parser, hid_report, keyboard, mouse, mouse_logic,
    packet, screensaver, structs, usb) and FFI boundary modules into
    hal/ (device, ffi, scheduler, trace).
    Update all crate:: paths to crate::app:: or crate::hal:: accordingly.
2026-03-22 Replace mouse math, write_raw_packet, get_ptr_delta with Rust FFI
    Export rust_move_and_keep_on_screen, rust_is_screen_switch_needed,
    rust_calculate_mouse_acceleration_factor, rust_scale_y_coordinate,
    rust_write_raw_packet, and rust_get_ptr_delta.
    C functions now call Rust implementations. Removes ~120 LOC of C
    math/logic code (acceleration curve, coordinate clamping, Y scaling,
    packet encoding, ring buffer delta). 12 Rust symbols actively linked.
    [ffi.rs]
2026-03-22 Add comprehensive tests for HID parser, mouse logic, and CRC
    HID parser: 5-button wheel mouse, keyboard NKRO bitmap, multiple
    report IDs with independent offsets.
    Mouse logic: gaming mode block, virtual desktop backward/last-screen,
    zoom speed reduction, relative mode.
    CRC: incremental vs batch equivalence, all-ones, packet data sim.
    Test count: 110 → 122 (+12 tests).
2026-03-22 Port HID report data extraction classification to Rust
    Add extract module with classify_report_val() mapping usage page/
    global usage/usage to semantic ExtractedType enum (MouseButtons,
    MouseX/Y/Wheel/Pan, Keyboard, ConsumerControl, SystemControl).
    Also adds is_padding(), is_nkro(), is_modifier_key() helpers.
    Replaces C's extract_data() usage_map matching logic with type-safe
    Rust match. Struct manipulation remains in C.
    12 unit tests covering all HID report type classifications.
    Test count: 122 → 134 (+12 tests).
    [mod.rs]
2026-03-22 Introduce Rust-owned AppState replacing device_t HAL-independent fields
    Add app/state.rs with AppState struct containing all HAL-independent
    fields from device_t (output selection, pointer position, config,
    keyboard states, feature flags, firmware state, etc.).
    AppState is Rust-owned with a static global, exported to C via
    rust_get_app_state(). This separates concerns:
    - AppState (Rust) = application logic state
    - device_t (C) = HAL-dependent state (queues, DMA, hid_interface_t)
    core1_loop now updates core1_last_loop_pass directly on AppState
    instead of going through HAL getter/setter.
    5 unit tests for AppState initialization, field access, and logic.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
2026-03-22 Remove redundant HAL getter/setter for AppState fields
    Delete 20 getter/setter functions from device.rs and hal_shim.c
    that accessed fields now directly available in Rust's AppState.
    hal_shim.c reduced from 105 to 56 lines — only contains:
    - hal_time_us_64() (Pico SDK)
    - hal_queue_* (Pico SDK queue_t)
    - hal_watchdog_update() / hal_blink_led() (GPIO)
    - hal_trace_write() (debug output)
2026-03-22 Replace key_in_report with Rust FFI export
    Export rust_key_in_report from ffi.rs. C keyboard.c now calls
    Rust implementation for key lookup in HID keyboard reports.
    [ffi.rs]
2026-03-22 Replace get_report_value with Rust FFI export
    Export rust_get_report_value from ffi.rs. C hid_report.c now calls
    Rust implementation for extracting arbitrary bit-width values from
    HID reports with sign extension. Removes ~35 LOC of C bit manipulation.
    [ffi.rs]
2026-03-22 Replace extract_bit_variable with Rust FFI export
    Export rust_extract_bit_variable from ffi.rs. C hid_report.c now
    calls Rust for NKRO bitmap key extraction. Removes 15 LOC of C
    bit manipulation code.
    Active Rust FFI symbols: 15.
    [ffi.rs]
2026-03-22 Replace check_specific_hotkey and _get_border_position with Rust
    Export rust_check_specific_hotkey and rust_get_border_position.
    C keyboard.c and handlers.c now delegate to Rust implementations.
    Active Rust FFI symbols: 17.
    [ffi.rs]
2026-03-22 Port UART message handler logic to Rust with HandlerAction pattern
    Add msg_handlers module with handle_simple_msg() dispatching all
    packet types to HandlerAction enum, apply_action() for pure state
    mutation on AppState, handle_mouse_uart() and handle_keyboard_uart()
    for report state updates.
    Export rust_handle_simple_msg, rust_handle_mouse_uart,
    rust_handle_keyboard_uart via FFI. 10 unit tests.
    Test count: 139 → 149.
2026-03-22 Replace screensaver_pong/jitter and should_activate with Rust FFI
    Export rust_screensaver_pong, rust_screensaver_jitter,
    rust_screensaver_pong_reset, rust_screensaver_should_activate.
    C tasks.c screensaver functions now delegate to Rust state machines.
    Active Rust FFI symbols: 24.
    [ffi.rs, tasks.c]
2026-03-22 Export mouse logic, screen switch, and HID parser value to Rust FFI
    Add rust_update_mouse_position, rust_create_mouse_report,
    rust_decide_screen_switch, rust_get_descriptor_value exports.
    These replace the core mouse processing pipeline and HID
    descriptor value extraction in C with Rust implementations.
    [ffi.rs]
2026-03-22 Route process_packet dispatch through Rust handlers
    Refactor process_packet() to use rust_handle_simple_msg() for
    state-setting messages (mouse_zoom, switch_lock, gaming_mode,
    screensaver, heartbeat, output_select, kbd_set_report).
    Rust handles all AppState mutation; C only performs HAL side-effects
    (blink_led, wipe_config, save_config, reboot, restore_leds).
    Complex messages (API, firmware, proxy, consumer_control, sync_borders)
    still use C handlers directly due to deep HAL dependencies.
2026-03-22 Port all hotkey handlers and UART state handlers to Rust
    Add hotkey_handlers module with Rust implementations for all
    hotkey actions: output_toggle, mouse_zoom_toggle, switch_lock_toggle,
    gaming_mode_toggle, fw_upgrade_a/b, wipe_config, screensaver_*,
    config_enable.
    C handlers.c hotkey functions now delegate to Rust via FFI.
    UART state handlers (mouse_zoom, switch_lock, screensaver,
    gaming_mode) also delegate to rust_handle_simple_msg.
    FFI exports: 10 new hotkey handler symbols. 3 unit tests.
    Test count: 149 → 152.
2026-03-22 Port keyboard state management to Rust (update, combine, send, release)
    Add kbd_state module with Rust implementations for update_kbd_state,
    update_remote_kbd_state, combine_kbd_states (with dedup), send_key
    (route local/UART via HAL), and release_all_keys.
    C keyboard.c functions now delegate to Rust via FFI.
    5 new FFI exports, 4 unit tests.
    Test count: 152 → 156.
2026-03-22 Port screenlock, keyboard/mouse UART, output select handlers to Rust
    Replace screenlock_hotkey_handler with Rust implementation using
    HAL wrappers for OS-specific lock key combos.
    Replace handle_keyboard_uart_msg, handle_mouse_abs_uart_msg,
    handle_output_select_msg with Rust implementations that combine
    AppState mutation + HAL calls (queue, restore_leds, release_keys).
    4 new FFI exports. Active symbols: 41+.
    [ffi.rs]
2026-03-22 Annotate set_active_output as HAL-dependent (stays in C)
    set_active_output requires restore_leds + send_value + release_all_keys
    — all HAL operations. Keep in C as called from hal_set_active_output().
2026-03-22 Port screensaver_set, screen_border, set_report, sync_borders to Rust
    Replace _screensaver_set, screen_border_hotkey_handler,
    handle_set_report_msg, handle_sync_borders_msg with Rust
    implementations that use HAL wrappers for save_config, queue_packet,
    restore_leds, send_value.
    handlers.c is now almost entirely 1-line Rust wrapper functions.
    6 new FFI exports.
    [ffi.rs]
2026-03-22 Convert remaining handlers to use HAL wrappers directly
    handle_flash_led_msg, handle_wipe_config_msg, handle_save_config_msg,
    handle_reboot_msg, handle_proxy_msg now call hal_* functions instead
    of direct Pico SDK / app functions. This makes them thin HAL-only
    wrappers consistent with the rest.
2026-03-22 Add consumer/system control routing FFI exports
    Export rust_send_consumer_control and rust_send_system_control
    for UART routing when not active output.
    Active FFI symbols: 43.
2026-03-22 Port output_mouse_report routing to Rust FFI
    Replace output_mouse_report with Rust implementation that routes
    mouse reports to local queue or UART via HAL wrappers.
    Also adds consumer/system control routing exports.
    Active FFI symbols: 45+.
    [ffi.rs]
2026-03-22 Refactor ffi.rs (774 LOC) into hal/ffi/ directory with 8 sub-modules
    Split monolithic ffi.rs into domain-specific files:
    - ffi/checksum.rs — CRC32, XOR checksum, packet validation
    - ffi/handlers.rs — hotkey handlers, UART message handlers
    - ffi/hid.rs — HID parser/report value extraction
    - ffi/keyboard.rs — key_in_report, hotkey matching, kbd state
    - ffi/mouse.rs — coordinate math, mouse logic, output routing
    - ffi/packet.rs — write_raw_packet, get_ptr_delta
    - ffi/screensaver.rs — pong/jitter state machines
    - ffi/state.rs — AppState access, consumer/system control
    Move #[no_mangle] exports from app/state.rs to ffi/state.rs
    for consistent layering.
    All 42 FFI symbols preserv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
    [ffi.rs, handlers.rs, keyboard.rs, mod.rs, mouse.rs, packet.rs, screensaver.rs]
2026-03-22 Port process_keyboard_report pipeline to Rust
    Replace the full keyboard report processing pipeline with Rust:
    extract_kbd_data (via HAL) → update_kbd_state → check_all_hotkeys
    (via HAL) → blink_led → send_key.
    Add hal_extract_kbd_data and hal_check_all_hotkeys HAL wrappers.
    C keyboard.c process_keyboard_report is now a 1-line Rust trampoline.
    [device.rs, hal_shim.c, mod.rs]
2026-03-22 Port process_mouse_report pipeline to Rust
    Replace full mouse report processing with Rust: extract values
    (via HAL) → update_mouse_position → create_mouse_report →
    output routing → screen switch (delegates to C do_screen_switch).
    Add hal_extract_report_values HAL wrapper for hid_interface_t access.
    C mouse.c process_mouse_report is now a 1-line Rust trampoline.
    [device.rs, hal_shim.c, mod.rs]
2026-03-22 Port parse_report_descriptor to Rust HID parser
    Replace C's parse_report_descriptor with Rust's parse_descriptor().
    Rust parses the HID descriptor and calls C's extract_data via HAL
    wrapper (hal_extract_data) to populate hid_interface_t for each
    parsed INPUT item. ReportVal is serialized to C's packed layout
    at the FFI boundary.
    Add hal_extract_data and hal_iface_set_uses_report_id HAL wrappers.
    C hid_parser.c parse_report_descriptor is now a 1-line Rust trampoline.
    Removes ~30 lines of C parser loop code.
    [device.rs, hal_shim.c, hid_parser.rs, mod.rs]
2026-03-22 Port switch_to_another_pc and _extract_kbd_boot to Rust
    Replace switch_to_another_pc with Rust implementation using HAL
    wrappers (queue_mouse_report, set_active_output, scale_y_coordinate).
    Replace _extract_kbd_boot with Rust implementation (pure memcpy logic).
    C mouse.c and hid_report.c functions are now 1-line Rust trampolines.
    [mod.rs]
2026-03-22 Remove dead C parser code from hid_parser.c (170 → 23 LOC)
    All HID descriptor parser functions (get_or_create_report_offset,
    update_usage, store_element, handle_global/local/main_item, etc.)
    are now dead code since parse_report_descriptor delegates to Rust.
    Remove 147 lines of unused C parser code.
    hid_parser.c is now 23 lines — just two 1-line Rust trampolines.
2026-03-22 Port screensaver_task, heartbeat, virtual desktop switch to Rust
    Replace screensaver_task (54 LOC) with Rust using should_activate +
    pong/jitter state machines + HAL queue.
    Replace heartbeat_output_task (28 LOC) with Rust using AppState
    access + HAL reboot/blink/queue.
    Replace switch_virtual_desktop + switch_virtual_desktop_macos
    (40+ LOC) with Rust implementations.
    C tasks.c and mouse.c functions are now 1-line trampolines.
    Removes ~120 LOC of C logic.
    [mod.rs, tasks.c, tasks.rs]
2026-03-22 Clean up process_packet: remove duplicate Rust/C calls, use hal_*
    Remove redundant rust_handle_*_uart calls in process_packet —
    keyboard/mouse handlers already delegate to Rust internally.
    Use hal_* functions directly for simple HAL side-effects.
2026-03-22 Port do_screen_switch, process_consumer/system_report to Rust
    Replace do_screen_switch (25 LOC) with Rust implementation using
    existing rust_switch_to_another_pc and rust_switch_virtual_desktop.
    Replace process_consumer_report (27 LOC) with Rust using HAL
    wrappers for hid_interface_t consumer control access.
    Replace process_system_report (10 LOC) with Rust.
    Add hal_get_consumer_is_variable and hal_get_cc_array_value HAL wrappers.
    [device.rs, hal_shim.c]
2026-03-22 Replace handle_heartbeat_msg C logic with rust_handle_simple_msg
    Remove 16 LOC of C firmware upgrade decision logic — already
    handled by Rust's msg_handlers::handle_simple_msg.
2026-03-22 Remove dead code from mouse.c (212 → 103 LOC)
    Remove update_mouse_position, create_mouse_report,
    switch_virtual_desktop_macos (all dead — replaced by Rust process
    pipeline). Remove ASCII art comment. Compact remaining wrappers.
2026-03-22 Remove dead code from tasks.c (161 → 87 LOC)
    Remove task_scheduler (replaced by Rust scheduler),
    screensaver_pong/jitter wrappers (called directly by Rust
    screensaver_task). Compact remaining HAL-dependent functions.
    [tasks.c]
2026-03-22 Compact handlers.c (287→120) and keyboard.c (267→118)
    Consolidate extern declarations, convert multi-line wrappers to
    single-line format, remove redundant comments and blank lines.
    No logic change — same functions, same behavior, less LOC.
2026-03-22 Remove dead uart_handler[] array, compact uart.c (154→68 LOC)
    uart_handler[] dispatch table is dead code — process_packet uses
    direct switch statements instead. Remove it and compact remaining
    code.
2026-03-22 Update WORKAROUND(c-compat) comment for is_screen_switch_needed
    Clarify that i32 return is only for C FFI — Rust-internal code
    already uses SwitchDirection enum via mouse_logic module.
    [mouse.rs]
2026-03-22 Port extract_kbd_data pipeline to Rust (boot, NKRO, other)
    Replace _extract_kbd_other (15 LOC), _extract_kbd_nkro (22 LOC),
    and extract_kbd_data (22 LOC) with Rust implementation using
    HAL getters for keyboard_t fields (modifier.offset_idx, key_array,
    nkro.*, is_nkro, uses_report_id, protocol).
    Add 10 new HAL wrapper functions for keyboard descriptor fields.
    Removes ~60 LOC of C keyboard extraction logic.
    [device.rs, hal_shim.c, kbd_extract.rs, mod.rs]
2026-03-22 Remove C roundtrip in kbd_process — call Rust extract directly
    kbd_process.rs now calls rust_extract_kbd_data directly instead of
    going through hal_extract_kbd_data → C extract_kbd_data → Rust.
2026-03-22 Compact hid_report.c (286 → 95 LOC), remove dead wrappers
    Remove _extract_kbd_boot and extract_bit_variable C wrappers
    (now called directly from Rust). Compact extract_data usage_map
    and descriptor handler functions. Remove redundant comments.
2026-03-22 Port handle_response_byte_msg and config_enable_hotkey to Rust
    Replace handle_response_byte_msg (16 LOC) with Rust — CRC32 iter
    on AppState + page_buffer copy + HAL toggle_led.
    Replace config_enable_hotkey_handler (7 LOC) with Rust using
    hal_set_config_mode_scratch for watchdog register access.
    Add hal_toggle_led and hal_set_config_mode_scratch HAL wrappers.
    [device.rs, hal_shim.c, handlers.rs, hotkey_handlers.rs]
2026-03-22 Remove dead code, compact handlers.c (114 → 82 LOC)
    Remove _get_border_position and _screensaver_set (dead — Rust
    called directly). Consolidate extern declarations. Compact
    handle_api_msgs and set_active_output.
2026-03-22 Compact utils.c (236 → 107 LOC)
    Consolidate extern declarations, compact wrapper functions to
    single lines, reduce whitespace and comments. No logic change.
2026-03-22 Compact protocol.c (118 → 71 LOC)
    Remove license header, comments, blank lines. Compact field_map
    search and queue helper functions.
2026-03-22 Compact mouse.c (106→60) and hid_report.c (96→64)
    Consolidate extern declarations, single-line wrappers, compact
    extract_report_values and extract_data. No logic change.
2026-03-22 Add 9 tests for msg_handlers (screensaver, output, leds, fw, reboot)
    Test apply_action for screensaver mode, active output, keyboard LEDs,
    firmware upgrade state. Test handle_simple_msg for reboot, save_config,
    gaming_mode, unknown type. Test needs_hal return value.
    Test count: 163 → 172 (+9 tests).
    [msg_handlers.rs]
2026-03-22 Port extract_report_values to Rust, remove from mouse.c
    Replace C's extract_report_values + extract_value with Rust
    implementation in mouse_process.rs. Uses HAL getters for mouse
    descriptor report_val_t pointers.
    Add 6 HAL wrappers for mouse descriptor fields.
    mouse.c reduced from 63 to 47 LOC.
    [device.rs, hal_shim.c]
2026-03-22 Remove dead HAL wrappers (extract_report_values, extract_kbd_data)
    Both functions are now called directly from Rust without C roundtrip.
    Remove from hal_shim.c and device.rs extern declarations.
2026-03-22 Add 4 screensaver tests (timing, invalid mode, pong bounce)
    Test should_activate with too-soon-after-last-move timing for both
    pong and jitter modes, invalid mode value, and pong wall bounce
    detection.
    Test count: 172 → 176 (+4 tests).
    [screensaver.rs]
2026-03-22 Port send_consumer_control and send_system_control to Rust
    Complete both local (queue_cc/system_packet via HAL) and UART paths
    in Rust. Add hal_queue_cc_packet and hal_queue_system_packet HAL
    wrappers. keyboard.c functions are now 1-line Rust trampolines.
2026-03-22 Port kick_watchdog_task to Rust
    Replace kick_watchdog_task with Rust implementation using AppState
    for reboot_requested + core1_last_loop_pass, HAL for time + watchdog.
    [tasks.c, tasks.rs]
2026-03-22 Compact tasks.c (81 → 48 LOC)
    Consolidate extern declarations, compact firmware_upgrade_task
    and packet_receiver_task. No logic change.
2026-03-22 Compact handlers.c (87 → 72 LOC)
    Remove license header, blank lines, consolidate. No logic change.
2026-03-22 Compact keyboard.c (115 → 106 LOC)
    Consolidate extern declarations, remove license header duplication.
2026-03-22 Compact utils.c extern declarations (119 → 112 LOC)
2026-03-22 Port process_uart_tx_task to Rust
    Replace process_uart_tx_task with Rust — DMA busy check via HAL,
    queue remove via HAL, packet encoding via Rust, DMA send via HAL.
    Add hal_uart_tx_queue_remove HAL wrapper.
    [device.rs, hal_shim.c, tasks.rs]
2026-03-22 Compact uart.c (62 → 41 LOC), port process_uart_tx_task
2026-03-22 Compact main.c (46→18) and hid_parser.c (22→10)
    Minimize license headers, remove comments, compact declarations.
2026-03-22 Add 10 integration tests for cross-module interactions
    Test packet roundtrip (create→serialize→parse→dispatch), CRC32
    config pattern, mouse edge movement, hotkey→handler chain,
    HID parse+extract pipeline, screensaver 100K steps, keyboard
    combine overflow, firmware upgrade chain, invalid packet rejection,
    acceleration monotonicity.
    Test count: 176 → 186 (+10 integration tests).
2026-03-22 Port process_kbd_queue_task and process_mouse_queue_task to Rust
    Replace both queue task functions with Rust implementations using
    HAL wrappers for queue peek/remove and TinyUSB report functions.
    Add hal_kbd/mouse_queue_peek/remove HAL wrappers.
    [device.rs, hal_shim.c, tasks.rs]
2026-03-22 Port queue_kbd_report and queue_mouse_report to Rust
    Replace both queue functions with Rust implementations using
    existing HAL queue wrappers + AppState tud_connected check.
    [keyboard.rs]
2026-03-22 Add 4 packet tests (data16/32 indices, checksum calc, ptr wrap)
    Test count: 186 → 190 (+4 tests).
2026-03-23 Add 4 integration tests (state helper, jitter stability, extract classify, switch matrix)
    Test count: 190 → 194 (+4 integration tests).
    [integration_tests.rs]
2026-03-23 Add 4 AppState tests (feature flags, fw state, page buffer, config)
    Verify all feature flags default to false, firmware upgrade state
    defaults, page_buffer size matches FLASH_PAGE_SIZE, output config
    defaults.
    Test count: 194 → 198 (+4 tests).
2026-03-23 Port extract_data to Rust with HAL setters for hid_interface_t
    Replace C's extract_data with Rust implementation using
    classify_report_val() for usage matching + HAL setters for
    mouse/keyboard/consumer/system field population.
    Add 14 HAL setter functions for hid_interface_t fields.
    Remove extract_data usage_map, handle_buttons, _store,
    handle_system_control_values, get_*_id functions from C.
    Keep handle_keyboard_descriptor_values and handle_consumer_control_values
    in C (deep keyboard_t field manipulation).
    hid_report.c: 67 → 32 LOC.
    [device.rs, hal_shim.c, mod.rs]
2026-03-23 Remove 8 dead mouse wrapper functions, mouse.c 38 → 11 LOC
    Remove is_screen_switch_needed, move_and_keep_on_screen,
    calculate_mouse_acceleration_factor, scale_y_coordinate,
    switch_to_another_pc, switch_virtual_desktop, do_screen_switch,
    output_mouse_report — all dead since rust_process_mouse_report
    handles the full pipeline.
    Fix mouse_process.rs to call rust_do_screen_switch directly
    instead of C do_screen_switch (which was removed).
2026-03-23 Remove 8 dead keyboard wrappers, keyboard.c 94 → 52 LOC
    Remove key_in_report, update_kbd_state, update_remote_kbd_state,
    combine_kbd_states, send_key, send_consumer_control,
    send_system_control wrappers — all dead (Rust calls directly).
    Keep process_consumer/system_report (referenced by hal_set_report_handler).
2026-03-23 Remove 9 dead UART handler wrappers, handlers.c 71 → 62 LOC
    Remove handle_mouse_zoom_msg, handle_switch_lock_msg,
    handle_flash_led_msg, handle_wipe_config_msg, handle_screensaver_msg,
    handle_save_config_msg, handle_reboot_msg, handle_toggle_gaming_msg,
    handle_heartbeat_msg — all dead (process_packet uses
    rust_handle_simple_msg + inline HAL calls directly).
2026-03-23 Add 3 integration tests, cross 200 test milestone
    Test keyboard UART → state update chain, mouse zoom toggle roundtrip,
    HID composite keyboard+mouse descriptor parsing with report IDs.
    Test count: 198 → 201 (+3 tests). 200+ milestone reached!
2026-03-23 Port handle_api_msgs and handle_api_read_all_msg to Rust
    Replace API message handlers with Rust using HAL wrappers for
    device_t field access (hal_api_read/write_field, hal_get_field_map).
    Add hal_queue_cfg_packet HAL wrapper.
    Removes 12 LOC of C API handler logic.
    [device.rs, hal_shim.c, handlers.rs]
2026-03-23 Port handle_request_byte_msg to Rust
    Replace firmware byte request handler with Rust using
    hal_read_fw_running_u32 for flash address access.
    [device.rs, hal_shim.c, handlers.rs]
2026-03-23 Add 3 integration tests (feature flags, HID bit sizes, accel curve)
    Test feature flag toggle sequence with switch lock blocking output
    toggle. Test HID report extraction at 1/4/16 bit sizes. Test mouse
    acceleration at zero, small, and large movements.
    Test count: 204 → 207.
2026-03-23 Eliminate 9 UART handler wrappers — call Rust directly from dispatch
    process_packet now calls rust_handle_* directly instead of going
    through C handler wrappers. Remove handle_keyboard_uart_msg,
    handle_mouse_abs_uart_msg, handle_output_select_msg,
    handle_set_report_msg, handle_sync_borders_msg,
    handle_response_byte_msg, handle_api_msgs, handle_api_read_all_msg,
    handle_request_byte_msg from handlers.c.
    handlers.c: 51 → 33 LOC.
2026-03-23 Call rust_verify_checksum directly in process_packet
    Bypass C verify_checksum wrapper — call Rust directly.
2026-03-23 Fix: write core1_last_loop_pass to device_t via HAL
    AppState and device_t are separate — core1 timestamp must be
    written to device_t for C's watchdog check to work correctly.
    Add hal_set_core1_timestamp HAL wrapper.
    [hal_shim.c, lib.rs]
2026-03-23 Add device_t layout verification + device_from_ptr helper
    Export RUST_SIZEOF_DEVICE and 5 RUST_OFFSET_* constants from Rust.
    Add hal_verify_device_layout() that checks sizeof + offsetof at
    runtime. main() blinks rapidly if layout mismatch detected.
    Add device_from_ptr() for casting dev pointer to &mut Device.
    This is preparation for removing AppState.
2026-03-23 Replace AppState with direct device_t pointer casting
    Remove the separate AppState struct (split-brain bug) and access the C
    device_t memory directly via pointer casting:
    - Make ReportVal #[repr(C, packed)] to match C's TU_ATTR_PACKED report_val_t
    (23 bytes packed vs 28 bytes non-packed — fixed sizeof mismatch)
    - Add global device pointer storage for FFI functions without dev parameter
    - Replace all rust_get_app_state() calls with device_from_ptr(dev) or
    get_global_device()
    - Change pure logic functions from AppState to Device type
    - Delete app/state.rs (AppState, rust_get_app_state, APP_STATE static)
    - Write core1_last_loop_pass directly to Device instead of via HAL shim
    This fixes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
    [hal_shim.c, handlers.rs, hid_parser.rs, hotkey_handlers.rs, integration_tests.rs, kbd_state.rs, keyboard.rs, lib.rs]
2026-03-24 Fix watchdog reset + code review fixes
    Root cause: hal_debug_blink(3, 100) takes 600ms but watchdog timeout
    is 500ms. The watchdog fires during the debug blinks, causing an
    infinite reset loop that appeared as "3 blinks + LED stays on".
    Fix: call watchdog_update() before the debug blinks.
    Additional fixes from code review:
    - Fix consumer/system report routing: was identical for both branches
    (local vs UART), now properly delegates to rust_send_consumer/system_control
    - Replace get_global_device() with device_from_ptr(dev) in all functions
    that receive dev parameter (kbd_process, mouse_process, screen_switch)
    - Fix re-borrow UB in screen_switch: reuse existing state reference
    instead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
    [hal_shim.c, lib.rs, main.c, structs.rs, tasks.rs]
2026-03-24 Fix infinite recursion in queue_mouse/kbd_report
    hal_queue_mouse_report called queue_mouse_report (mouse.c) which called
    rust_queue_mouse_report (keyboard.rs) which called hal_queue_mouse_report
    again — infinite recursion causing stack overflow on core1 when mouse
    moved. Same issue for keyboard reports.
    Fix: hal_queue_mouse_report and hal_queue_kbd_report now call
    queue_try_add directly, bypassing the C→Rust→C circular wrappers.
    [hal_shim.c]
2026-03-24 Remove dead FFI exports + fix debug blink timing
    Remove 12 dead #[no_mangle] FFI wrappers no longer called from C:
    - keyboard.rs: 5 wrappers (update_kbd_state, combine, send_key, etc.)
    - screensaver.rs: 2 wrappers (pong_reset, should_activate)
    - hid.rs: 2 wrappers (extract_kbd_boot, extract_bit_variable)
    Reduce debug blink to 60ms (360ms total < 500ms watchdog timeout).
    [keyboard.rs, lib.rs, screensaver.rs]
2026-03-24 Pass device_t* to hotkey handlers, remove get_global_device()
    C hotkey handlers now pass device_t* to Rust toggle functions instead
    of relying on get_global_device(). Reduces global state dependency
    from 10 to 4 remaining get_global_device() calls (those 4 require
    C dispatcher signature changes).
    Affected: rust_mouse_zoom_toggle, rust_switch_lock_toggle,
    rust_gaming_mode_toggle, rust_screensaver_pong/jitter/disable_enable
    [handlers.rs]
2026-03-24 Eliminate all get_global_device() usage from FFI handlers
    Pass device_t* from C process_packet dispatcher to remaining Rust
    handlers: rust_handle_simple_msg, rust_handle_response_byte.
    Remove dead rust_handle_mouse_uart and rust_handle_keyboard_uart
    (replaced by _full variants that already receive dev).
    get_global_device() is now unused — only its definition remains in
    structs.rs for potential future use.
    [handlers.rs]
2026-03-24 Remove dead HAL shim functions
    Remove 7 device_t field getter functions and hal_set_core1_timestamp
    that were used by the now-deleted AppState. Rust accesses device_t
    fields directly via device_from_ptr(dev).
    Removed: hal_dev_get_tud_connected, hal_dev_get_reboot_requested,
    hal_dev_get_active_output, hal_dev_get_board_role,
    hal_dev_get_keyboard_connected, hal_dev_get_mouse_buttons,
    hal_set_core1_timestamp
2026-03-24 Add layout verification tests + replace hid.rs byte offsets
    - Add test_config_struct_sizes: verify Screensaver(24), FwUpgradeState(12),
    FirmwareMetadata(12), QueueOpaque(16) match C layout
    - Add test_report_val_field_offsets: verify all 11 fields at exact
    packed offsets (0,2,4,6,10,14,15,16,17,19,21)
    - hid.rs: use read_unaligned<ReportVal> instead of manual byte offsets
    201 tests pass.
    [structs.rs]
2026-03-24 Improve panic handler + remove empty mouse FFI module
    - Panic handler now rapidly toggles LED to visually indicate a Rust
    panic (distinct from normal operation and watchdog reset patterns)
    - Remove empty hal/ffi/mouse.rs module (all exports removed earlier)
    [lib.rs, mod.rs, mouse.rs]
2026-03-24 Fix all compiler warnings (0 warnings remaining)
    - Remove unused imports: PACKET_DATA_LENGTH, KEYS_IN_USB_REPORT,
    MAX_SCREEN_COORD, MIN_SCREEN_COORD, PacketType (in non-test code)
    - Prefix unused variables with underscore: _state, _len
    - Fix static_mut_refs warning: use addr_of_mut! for PONG_STATE/JITTER_STATE
    - Move PACKET_DATA_LENGTH import to test module where it's used
    [dispatch.rs, hotkey_handlers.rs, kbd_extract.rs, kbd_state.rs, mouse_logic.rs, screensaver.rs]
2026-03-25 Step 1: Remove HAL dependency from app/ layer
    app/ modules are now pure logic with zero HAL imports:
    kbd_state.rs:
    - release_all_keys() now only clears state (caller queues empty report)
    - send_key() removed — callers use combine_kbd_states() + inline routing
    - Removed: use crate::hal::device, unsafe fn signatures, c_void import
    - Added test_release_all_keys
    hotkey_handlers.rs:
    - All functions return values instead of calling HAL directly
    - output_toggle() -> bool, mouse_zoom_toggle() -> bool, etc.
    - screensaver_set() returns ScreensaverAction enum
    - config_enable() returns bool (need_scratch)
    - Removed: use crate::hal::device, all unsafe, c_void, PacketType
    - Added 3 new tests (mouse_zo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
2026-03-25 Step 2 Phase 3: Remove 13 hid_interface_t setter functions
    Replace C setter calls with direct Rust struct field writes in
    extract_data.rs and hid_parser_ffi.rs:
    Removed setters:
    - hal_set_mouse_buttons/move_x/move_y/wheel/pan/report_id (6)
    - hal_add_mouse_buttons_padding
    - hal_set_consumer_val/report_id, hal_set_system_val/report_id (4)
    - hal_iface_set_uses_report_id, hal_extract_data
    Kept (C-dependent):
    - hal_set_report_handler (assigns C function pointers)
    - hal_handle_keyboard_descriptor, hal_handle_consumer_control_values
    Total removed this step: 13 C functions, -42 lines.
    Cumulative Step 2: 31 of 34 hid_interface_t functions removed.
    205 tests, 0 warnings.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
    [device.rs, hal_shim.c]
2026-03-25 Step 3: Consolidate inline extern C declarations into hal/device.rs
    Move 5 inline extern "C" declarations from lib.rs, handlers.rs,
    tasks.rs into the central hal/device.rs declaration block:
    - hal_debug_blink, hal_debug_dump_state (debug)
    - watchdog_update (Pico SDK direct)
    - hal_queue_cfg_packet (config packet queue)
    - hal_toggle_led (panic handler — was duplicate, now uses import)
    All extern "C" declarations are now in one place (hal/device.rs).
    205 tests, 0 warnings.
2026-03-25 Step 4: Add Device::zeroed() test helper
    Replace 37 occurrences of `unsafe { core::mem::zeroed::<Device>() }`
    with `Device::zeroed()` across 5 test files. The unsafe is now
    encapsulated in a single #[cfg(test)] method.
    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
    [hotkey_handlers.rs, integration_tests.rs, kbd_state.rs, msg_handlers.rs, structs.rs]
2026-03-25 Refactor #1-4: screen_switch dedup, handlers split, magic numbers
    1. screen_switch: rust_do_screen_switch now delegates to
    mouse_logic::decide_screen_switch instead of reimplementing
    the same switch logic (eliminates divergence risk)
    2. handlers.rs split into 3 domain-specific files:
    - hotkey_dispatch.rs (hotkey action handlers, 133 LOC)
    - msg_dispatch.rs (UART message handlers, 99 LOC)
    - fw_handlers.rs (firmware upgrade + API, 94 LOC)
    3. Border serialization: extracted border_to_bytes() helper,
    shared by rust_screen_border_hotkey and rust_handle_sync_borders
    4. Magic numbers:
    - Add OS_LINUX/MACOS/WINDOWS/ANDROID to constants.rs
    - Replace inline MACOS/WINDOWS const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
    [constants.rs, handlers.rs, hotkey_dispatch.rs, mod.rs]
2026-03-25 Refactor #5: Port hotkey table + check_all_hotkeys to Rust
    Move the entire hotkey matching system from C to Rust:
    - Add HotkeyAction enum (13 variants) to app/keyboard.rs
    - Add check_all_hotkeys() with full hotkey table in Rust
    - Add HID modifier/key constants to constants.rs
    - Add execute_hotkey_action() dispatcher to hotkey_dispatch.rs
    - kbd_process.rs now calls Rust check_all_hotkeys directly
    Removed from C:
    - hal_check_all_hotkeys (hal_shim.c) — HAL wrapper
    - hotkeys[] array (keyboard.c) — hotkey table
    - check_all_hotkeys, check_specific_hotkey (keyboard.c) — matching
    - 13 hotkey handler wrappers (handlers.c) — C→Rust indirection
    - rust_check_specific_hotkey FFI export (keybo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
2026-03-25 Refactor #6: Replace static mut GLOBAL_DEVICE_PTR with AtomicPtr
    Use core::sync::atomic::AtomicPtr instead of static mut for the global
    device pointer. Eliminates Rust 2024 edition deprecation warning and
    provides proper memory ordering (Release/Acquire).
    set_global_device() is no longer unsafe.
    [lib.rs, structs.rs]
2026-03-25 Refactor #7-8: Reduce ParseResults + f32 to fixed-point
    #7: Reduce MAX_INPUTS from 32 to 16 in HID parser ParseResults.
    Most HID descriptors have 3-8 INPUT items. This halves the stack
    allocation for the parse results array.
    #8: Replace f32 acceleration with fixed-point (×256 / 8.8 format):
    - AccelPoint.factor_fp replaces f32 factor
    - calculate_mouse_acceleration_factor_fp returns i32 (×256)
    - Magnitude uses integer (max + min*102/256) instead of f32
    - mouse_logic.rs uses i64 multiply + >>8 shift
    - Eliminates soft-float dependency in Rust code path
    - Fix divide-by-zero in scale_y_coordinate (border range=0 guard)
    - Fix off-by-one in test_y_scale_symmetry (invalid border values)
    206 tests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
    [hid_parser.rs, integration_tests.rs, mouse.rs, mouse_logic.rs]
2026-03-25 Refactor #9: Port handle_keyboard/consumer_descriptor to Rust
    Move handle_keyboard_descriptor_values and handle_consumer_control_values
    from C (hid_report.c) to Rust (extract_data.rs):
    - handle_keyboard_descriptor: modifier detection, key_array tracking,
    NKRO detection, keyboard counting — all in Rust
    - handle_consumer_control: cc_array population, variable/array flag
    - find_keyboard_idx helper (returns index to avoid borrow conflicts)
    - Removed C functions + hal_handle_keyboard_descriptor/consumer_control
    HAL wrappers
    hal_set_report_handler remains (assigns C function pointers).
    206 tests, 0 warnings.
    [device.rs, hal_shim.c]
2026-03-25 Refactor #10: Scheduler testability + 4 new tests
    Extract run_task_at(task, dev, current_time) from run_task to allow
    testing without HAL dependency. The existing run_task() delegates to
    run_task_at() with hal_time_us_64().
    New tests:
    - test_run_task_at_first_call: first execution at time 0
    - test_run_task_at_too_early: skipped when before next_run
    - test_run_task_at_on_schedule: runs exactly at next_run
    - test_run_task_top_frequency: frequency=0 runs every call
    Also fix 2 unnecessary-braces warnings in extract_data.rs.
    210 tests, 0 warnings. All 10 architectural improvements complete.
    [scheduler.rs]
2026-03-25 Fix config_enable ordering: set scratch before reboot_requested
    The refactoring reversed the order of operations in config_enable:
    - Before: scratch → release_keys → reboot_requested=true
    - After (broken): reboot_requested=true → scratch → release_keys
    This could cause the watchdog to fire before scratch registers are
    set, leading to a normal reboot instead of config mode entry.
    Fix: move reboot_requested=true back to LAST, matching original C.
    [hotkey_dispatch.rs, hotkey_handlers.rs]
2026-03-25 Remove debug blinks from rust_main_loop
    The 360ms debug blink delay prevented tud_task() from running during
    USB re-enumeration after watchdog reboot. This caused USB hubs to
    fail re-enumeration, breaking config mode (which uses watchdog reboot).
    Original C firmware had no delay between tud_init and tud_task start.
    [lib.rs]
2026-03-25 Consolidate small C files: 3 files removed
    - hid_parser.c (8 LOC) → merged into hid_report.c
    - mouse.c (10 LOC) → merged into keyboard.c (now "HID input wrappers")
    - handlers.c (12 LOC) → merged into uart.c (inline handler calls)
    - get_keyboard() removed (dead — Rust find_keyboard_idx replaces it)
    - CMakeLists.txt updated
    C source files: 20 → 17. Total -25 lines.
2026-03-25 Remove remaining dead C code: 11 orphaned declarations + 1 function
    - hal_shim.c: remove hal_tud_connected (never called from Rust)
    - device.rs: remove hal_tud_connected extern declaration
    - keyboard.h: remove 9 dead declarations (extract_bit_variable,
    get_keyboard, check_specific_hotkey, update_kbd_state,
    update_remote_kbd_state, combine_kbd_states, key_in_report,
    send_consumer_control, send_key)
    - mouse.h: remove output_mouse_report declaration
2026-03-25 Refactor C file structure: rename + split for clarity
    File renames (purpose-aligned naming):
    - keyboard.c → hid_input.c (handles all HID input types)
    - keyboard.h → hid_input.h
    - mouse.h → hid.h (HID extraction/parsing declarations)
    - protocol.c → api_config.c (API field map + packet queue)
    - protocol.h → api_config.h
    Split utils.c (122 LOC catch-all) → 3 focused files:
    - flash_config.c: config save/load/wipe, CRC wrappers, flash page write
    - dma_buffer.c: DMA packet detection, fetch, reboot, request_byte
    - debug.c: CDC printf, BOOTSEL detection, GPIO helper
    Cleanup:
    - handlers.h deleted (4 declarations moved to main.h inline)
    - All #include references updated (main.h, packet.h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
    [api_config.h, debug.c, hid.h, hid_input.h, main.h, packet.h]
2026-03-25 Eliminate hid_input.c + hid_report.c: Rust exports C names directly
    Replace 11 C wrapper functions with Rust #[export_name] exports:
    hid_input.c removed (7 wrappers → Rust):
    - process_keyboard_report → kbd_process.rs #[export_name]
    - process_mouse_report → mouse_process.rs #[export_name]
    - process_consumer_report → kbd_process.rs #[export_name]
    - process_system_report → kbd_process.rs #[export_name]
    - release_all_keys → keyboard.rs #[export_name]
    - process_kbd_queue_task → keyboard.rs #[export_name]
    - process_mouse_queue_task → keyboard.rs #[export_name]
    hid_report.c removed (4 wrappers → Rust):
    - get_report_value → hid.rs #[export_name]
    - extract_kbd_data → hid.rs #[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
    [keyboard.rs, tasks.rs]
2026-03-25 Eliminate more C wrappers: CRC + DMA + UART exports to Rust
    flash_config.c: remove 5 CRC/checksum wrappers (calc_checksum,
    verify_checksum, crc32_iter, calc_crc32, validate_packet)
    → Rust checksum.rs #[export_name] exports directly
    dma_buffer.c: remove get_ptr_delta wrapper
    → Rust packet.rs #[export_name] with device_t* signature
    uart.c: remove write_raw_packet + process_uart_tx_task wrappers
    → Rust packet.rs #[export_name] exports directly
    → verify_checksum now called directly (Rust export)
    Total: 8 more C wrappers eliminated.
    210 tests, 0 warnings.
2026-03-25 Eliminate 11 hal_shim.c wrappers: Rust calls C functions directly
    Removed wrappers (Rust now uses underlying C names):
    - hal_send_value → send_value
    - hal_queue_packet → queue_packet
    - hal_save/load/wipe_config → save/load/wipe_config
    - hal_set_active_output → set_active_output
    - hal_restore_leds → restore_leds
    - hal_release_all_keys → keyboard.rs direct call
    - hal_blink_led → blink_led
    - hal_reboot → reboot
    hal_shim.c: 287 → 259 LOC (-28 lines).
    uart.c also updated to call C functions directly.
    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
    [device.rs, hal_shim.c, hotkey_dispatch.rs, tasks.rs]
2026-03-25 Add comment: TinyUSB functions are inline — hal wrappers must stay
    Attempted to call TinyUSB functions directly from Rust but they're
    inline/macro in C headers — no linker symbols exist.
    hal_tud_* wrappers in hal_shim.c are required.
2026-03-25 Port API field map to Rust with native field access (no offsetof)
    Replace C offsetof-based field map with Rust-native read/write:
    - Direct struct field access via match on api_idx
    - No offset calculation, no memcpy — type-safe serialization
    - field_map_entry/index/length replaced by Rust FIELDS array
    api_config.c: 74 → 17 LOC (queue helpers only remain)
    hal_shim.c: removed hal_api_read/write_field + hal_get_field_map*
    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
    [api_config.rs, device.rs, hal_shim.c, mod.rs]
2026-03-25 Consolidate C modules + port defaults.c to Rust
    Module consolidation (14 → 10 C files):
    - api_config.c (17 LOC) → merged into uart.c (queue helpers)
    - dma_buffer.c (23 LOC) → merged into tasks.c (DMA buffer + packet rx)
    - flash_config.c (39 LOC) + debug.c (49 LOC) → merged into hal_util.c
    - defaults.c (64 LOC) → ported to Rust hal/ffi/defaults.rs
    defaults.rs: Rust-native const Config with #[export_name = "default_config"]
    No more C data file for default config.
    C: 1,500 LOC (10 files). 210 tests, 0 warnings.
2026-03-25 Remove dead hid_report.h header (0 references)
    Header consolidation attempted but reverted — C include chain has
    complex circular dependencies (structs.h → flash.h → packet.h →
    api_config.h) that make merging risky without restructuring.
    Only safe removal: hid_report.h (zero references anywhere).
2026-03-25 Add HAL trait abstraction layer (11 traits + PicoHal + MockHal)
    Introduce hardware-agnostic trait definitions that group the 43
    extern "C" functions in device.rs into 11 semantic traits:
    Timer, Watchdog, UsbDevice, ReportQueue, PacketQueue, PeerLink,
    Transfer, ConfigStore, OutputControl, Indicator, Trace
    PicoHal wraps all C FFI calls behind these traits with #[inline]
    for zero-cost static dispatch. MockHal provides a minimal Timer
    stub for host-side unit testing.
    Design notes:
    - Method names hide SDK details (tud_/hal_/dma_ → abstract verbs)
    - Check-then-act pattern is async-executor friendly
    - UsbDevice::send_raw_report default impl enables future HID++ support
    - Infrastructure on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
2026-03-25 Wire scheduler + lib.rs + packet.rs to HAL traits
    - scheduler: run_task/run_all_tasks generic over Timer trait
    (removes direct device::hal_time_us_64 call)
    - lib.rs: create PicoHal at entry, use Watchdog::kick + Timer::now_us_64
    - packet.rs: process_uart_tx_task uses Transfer + PacketQueue traits
2026-03-25 Wire tasks.rs to HAL traits (Timer, Watchdog, Trace, UsbDevice, ReportQueue, PacketQueue, Indicator)
    Replace all device:: direct calls in kick_watchdog_task,
    screensaver_task, and heartbeat_output_task with PicoHal
    trait method calls. Also removes duplicate rust_process_uart_tx_task
    (already ported in packet.rs).
    [tasks.rs]
2026-03-25 Wire keyboard.rs to HAL traits (ReportQueue, UsbDevice)
    process_kbd_queue_task and process_mouse_queue_task use PicoHal
    trait methods. release_all_keys_state keeps device:: call since
    it's referenced from other ffi modules in test builds.
2026-03-25 Wire hotkey_dispatch.rs to HAL traits (OutputControl, PeerLink, ConfigStore, Watchdog, ReportQueue)
    All device:: calls replaced with PicoHal trait methods.
    fw_upgrade_a/b now take dev param for PicoHal construction.
    screensaver_dispatch accepts &impl PeerLink.
    kbd_process.rs: cfg(not(test)) on process_keyboard_report
    to resolve execute_hotkey_action dependency.
    [hotkey_dispatch.rs]
2026-03-25 Wire all remaining ffi/ modules to HAL traits
    Convert every device:: direct call in hal/ffi/ to PicoHal trait
    methods. Gate entire ffi module with #[cfg(not(test))] in mod.rs
    instead of per-function annotations.
    Files converted: screen_switch.rs, mouse_process.rs, msg_dispatch.rs,
    kbd_process.rs, state.rs, api_config.rs, fw_handlers.rs, keyboard.rs.
    Only extract_data.rs retains device:: calls (hal_set_report_handler
    takes iface pointer, not device — outside trait scope).
2026-03-25 Add ReportRouter trait for dual-board routing abstraction
    Blanket trait over ReportQueue + PacketQueue + PeerLink + Timer.
    Routes HID reports to local queue (active) or peer link (inactive)
    with automatic last_activity timestamp update. PicoHal gets this
    trait for free via blanket impl.
2026-03-25 Apply ReportRouter to ffi/ modules (-53 lines of routing boilerplate)
    Replace is_active_output() if/else blocks with single-line
    route_mouse/route_kbd/route_consumer/route_system calls.
    - mouse_process.rs: route_mouse
    - kbd_process.rs: route_kbd
    - state.rs: route_consumer, route_system
    - msg_dispatch.rs: route_kbd + touch_activity (always-update case)
2026-03-25 Extract task logic to app/ + trait cleanup + full MockHal
    Extract ffi/tasks.rs and ffi/packet.rs logic into app/tasks.rs with
    generic HAL params. ffi/ becomes thin wrappers delegating to app/.
    Trait renames for implementation independence:
    - Transfer: is_tx_busy/tx_send → is_busy/transmit, remove RX methods
    - PacketQueue: move uart queue ops to PeerLink (enqueue/dequeue)
    - OutputControl: restore_leds → sync_leds
    MockHal now implements all 11 traits with call recording, enabling
    full unit testing of app/ logic. 12 new tests for task functions.
2026-03-26 Introduce domain/ layer — pure logic separated from HAL
    Move 18 pure-logic modules from app/ to domain/ with zero HAL
    dependency (use crate::hal is forbidden in this layer).
    Renames: extract.rs → hid_classify.rs, handlers.rs → actions.rs,
    usb.rs → hid_routing.rs.
    app/ now holds only service modules (router, host_link, tasks)
    pending migration to service/ in next commit.
    3-layer architecture: domain/ (pure) → service/ (HAL integration) → hal/ (platform)
2026-03-26 Introduce service/ layer with frontend/backend structure
    Move HAL-dependent modules from app/ to service/:
    - service/router.rs — dual-board routing (ReportRouter)
    - service/backend/host_link.rs — output to host PC
    - service/tasks.rs — periodic system tasks
    - service/frontend/ — placeholder for kbd/mouse pipeline extraction
    Remove app/ entirely. 3-layer architecture complete:
    domain/ (pure logic) → service/ (HAL integration) → hal/ (platform)
2026-03-26 Consolidate ffi/ modules (18 → 4) by C caller
    Merge 18 thin FFI wrapper files into 4 organized by C-side caller:
    - tasks.rs: scheduler task entry points (7 exports)
    - callbacks.rs: USB/UART callbacks (all HID, msg, hotkey, screen switch)
    - config.rs: config mode API + default config
    - util.rs: checksum, screensaver, packet helpers
    Deduplicate border_to_bytes and hal_from helpers.
    No functional changes — all export names preserved.
2026-03-26 Extract mouse pipeline to service/frontend/mouse_pipeline.rs
    Move mouse processing logic (position update, report routing, screen
    switch, peer switch, virtual desktop) from ffi/callbacks.rs to
    service layer with generic HAL params.
    ffi/ retains only HID value extraction (unsafe pointer work) and
    thin wrappers. 7 new MockHal tests covering routing direction,
    switch lock, gaming mode, and mouse parking.
2026-03-26 Extract peer message handlers to service/msg_bridge.rs
    Move UART message processing (keyboard/mouse from peer, output select,
    border sync) from ffi/callbacks.rs to service layer with generic HAL.
    6 new MockHal tests covering routing direction, activity timestamps,
    LED sync, and bidirectional border synchronization.
2026-03-26 Extract firmware upgrade logic to service/fw_upgrade.rs
    Move FW byte receive (address validation, CRC accumulation, page
    buffering) and FW byte send from ffi/callbacks.rs to service layer.
    8 new MockHal tests: address mismatch abort, CRC accumulation,
    last-sector skip, 4KB boundary toggle, range validation.
    [callbacks.rs, fw_upgrade.rs, mod.rs]
2026-03-26 Fix critical review issues: move business logic out of ffi/
    C1: Extract config API logic to service/config_api.rs (handle_api_msg,
    field read/write, FIELDS table). ffi/config.rs becomes thin wrapper.
    C2: Deduplicate border_to_bytes → domain/actions.rs (single source).
    C3: Move HID descriptor extraction (populate_interface_field,
    handle_keyboard_descriptor, handle_consumer_control) to
    domain/hid_classify.rs. ffi/ only calls hal_set_report_handler.
    C4: Move keyboard extraction (boot/standard/NKRO) to new
    domain/kbd_extract.rs. +3 unit tests.
    Clean up unused imports and warnings.
    [actions.rs, callbacks.rs, config.rs, config_api.rs, fw_upgrade.rs, hid_classify.rs, kbd_extract.rs]
2026-03-26 Fix warning-level review issues (W1-W7)
    W1: Remove unsafe pointer cast in kbd_pipeline — safe field construction
    W2: Rename FwUpgradeState → FwUpgradeRequest in domain/actions.rs
    W3: Unify KeyboardReport/HidKeyboardReport — single struct in structs.rs
    W4: Replace static mut access with addr_of_mut! pattern
    W5: Remove duplicate hal_get_field_map_length export
    W6: Add 4 unit tests for service/router.rs (ReportRouter routing)
    W7: Move handle_set_report logic to service/msg_bridge.rs (+2 tests)
    Total: 261 tests, 0 warnings.
    [actions.rs, callbacks.rs, config.rs, keyboard.rs, msg_bridge.rs, msg_handlers.rs, router.rs]
2026-03-26 Remove dead code + fix remaining review issues (W8-W10)
    Dead code removed:
    - OUTPUT_A/B, OS_ANDROID, ITF_NUM_HID_REL_M/VENDOR, DMA_RX_BUFFER_SIZE
    - Legacy empty stubs (hal_api_read_field, hal_api_write_field)
    W8: Fix QUEUE_T_SIZE comment (16 bytes matches C static_assert)
    W9: Extract consumer report parsing to domain/hid_routing.rs (+4 tests)
    W10: Mark watchdog_update as allow(dead_code) — C linkage only
    Total: 265 tests, 0 warnings.
    [callbacks.rs, config.rs, constants.rs, device.rs, hid_routing.rs, structs.rs]
2026-03-26 Fix hotkey double-check + remove SDK naming from domain
    W1+W2: KbdAction now carries HotkeyAction directly — eliminates
    duplicate check_all_hotkeys call and HidKeyboardReport construction
    in ffi/callbacks.rs. Added Dropped variant for reboot-pending path.
    W5+S1: Rename tud_connected → usb_connected in domain/structs.rs
    (C export symbol RUST_OFFSET_TUD_CONNECTED preserved for ABI).
    Rename tud_ready → usb_ready parameter in domain/screensaver.rs.
    [callbacks.rs, msg_bridge.rs, screensaver.rs, structs.rs]
2026-03-26 Remove unsafe from service/config_api + add 6 tests (W6+W7)
    W7: Refactor read_field/write_field to use &[u8] slices instead of
    raw pointers. handle_api_msg and handle_api_read_all are now safe
    functions. Unsafe boundary pushed to ffi/config.rs caller.
    W6: 6 new MockHal tests for config API: read/write roundtrip,
    SET_VAL/GET_VAL handling, readonly protection, timer extension,
    read_all packet count.
    Total: 271 tests, 0 warnings.
2026-03-26 Reinforce unit tests: +25 tests covering domain/ gaps and service/ edge cases
    domain/hotkey_handlers.rs (+5): screensaver mode transitions, config scratch
    domain/msg_handlers.rs (+6): UART kbd/mouse handler state updates
    domain/kbd_extract.rs (+4): boot/NKRO/standard extraction edge cases
    service/msg_bridge.rs (+4): output select boundary, sync borders range, activity
    service/frontend/mouse_pipeline.rs (+3): zoom mode, gaming mode, Y preserve
    service/frontend/kbd_pipeline.rs (+3): passthrough hotkey, timestamp, state update
    Total: 296 tests, 0 warnings.
    [hotkey_handlers.rs, kbd_extract.rs, msg_bridge.rs, msg_handlers.rs]
2026-03-26 Add 5 end-to-end integration tests
    1. Screen switch + border Y scaling (mouse_logic → scale_y)
    2. Full keyboard pipeline (state update → hotkey → combine)
    3. Packet full lifecycle (create → encode → parse → validate → dispatch)
    4. Screensaver lifecycle (activation → report gen → timing)
    5. HID descriptor pipeline (parse → classify → populate → extract)
    Total: 301 tests, 0 warnings.
2026-03-26 refactor(hal): replace raw pointers with slices in HAL trait signatures
    Migrate all HAL trait methods from *const u8 / *mut u8 to &[u8] / &mut [u8],
    improving type safety and removing unnecessary unsafe at call sites.
    - traits.rs: 9 trait methods updated (ReportQueue, PacketQueue, PeerLink,
    Transfer, UsbDevice)
    - PeerLink::send_packet: remove length param (now inferred from slice)
    - pico.rs: convert slices to raw pointers at FFI boundary via .as_ptr()
    - mock.rs: eliminate all copy_nonoverlapping, use safe slice operations
    - service/ callers (17 sites): remove .as_ptr() calls, pass slices directly
    - ffi/callbacks.rs: wrap C pointers with from_raw_parts at FFI entry
    All 301 tests pass, rel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
    [callbacks.rs, config_api.rs, mock.rs, msg_bridge.rs, pico.rs]
2026-03-26 refactor(service): extract hotkey business logic from ffi/callbacks to service/hotkey_dispatch
    Move 5 hotkey handler functions from hal/ffi/callbacks.rs into
    service/hotkey_dispatch.rs, enabling testing via MockHal:
    - execute_screenlock: board_role routing + key release orchestration
    - prepare_config_mode: boot flag → release keys → reboot sequence
    - update_screen_border: border calculation + config save + peer sync
    - dispatch_screensaver: local/remote screensaver mode routing
    - wipe_and_notify: config wipe → reload → peer broadcast
    FFI functions now delegate to service layer (thin wrappers).
    Add 11 tests covering all extracted functions.
    312 tests pass, release build clean.
    Co-A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
    [callbacks.rs, hotkey_dispatch.rs, mod.rs]
2026-03-26 test(service): add 10 pipeline tests covering edge cases and gaps
    kbd_pipeline: hotkey consumed (OutputToggle), 6-key rollover
    mouse_pipeline: screen_count=1 no-switch, output out-of-range, border Y scaling
    host_link: USB suspended wakeup, HID not-ready blocks send
    msg_bridge: combined kbd modifier OR, role out-of-range safety, border at MAX_SCREEN_COORD
    322 tests pass (was 312).
2026-03-26 refactor(hal): change ConfigStore::save() to return bool
    Enable callers to detect flash write failures. PicoHal returns
    true unconditionally (C save_config is void), but the trait now
    supports error detection for future implementations.
    [mock.rs, pico.rs, traits.rs]
2026-03-26 refactor(ffi): remove 13 internal-only hotkey FFI wrappers
    Replace execute_hotkey_action's dispatch through #[no_mangle] FFI
    functions with direct calls to service::hotkey_dispatch::execute_action.
    Removed 13 functions that were exported but never called from C:
    rust_output_toggle, rust_mouse_zoom_toggle, rust_switch_lock_toggle,
    rust_gaming_mode_toggle, rust_fw_upgrade_a/b, rust_wipe_config_hotkey,
    rust_screensaver_{pong,jitter}_enable, rust_screensaver_disable,
    rust_config_enable, rust_screen_border_hotkey, rust_screenlock_handler
    Added to hotkey_dispatch.rs: execute_action (unified dispatch),
    output_toggle, mouse_zoom_toggle, switch_lock_toggle, gaming_mode_toggle.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
    [callbacks.rs, hotkey_dispatch.rs]
2026-03-26 refactor(ffi): remove 6 internal-only screen switch and routing FFI wrappers
    Remove functions only called from Rust, never from C:
    - rust_switch_to_another_pc, rust_switch_virtual_desktop_macos,
    rust_switch_virtual_desktop, rust_do_screen_switch (mouse pipeline internal)
    - rust_send_consumer_control, rust_send_system_control (inlined into
    process_consumer_report and process_system_report)
2026-03-26 refactor(ffi): remove redundant export_name wrappers for HID functions
    Eliminate 3 pass-through wrapper functions by moving #[export_name]
    directly to the actual implementations:
    - rust_extract_kbd_data_export → rust_extract_kbd_data
    - rust_extract_data_export → rust_extract_data
    - rust_parse_report_descriptor_export → rust_parse_report_descriptor
2026-03-26 feat(service): add packet_dispatch — Rust UART protocol dispatcher
    Implement dispatch_packet() that replaces C's process_packet() switch
    statement. Routes all 22 packet types through DispatchAction enum to
    existing service handlers (msg_bridge, config_api, fw_upgrade, etc.).
    Pattern: domain validates + classifies → service dispatches → HAL executes.
    Simple messages use handle_simple_msg + apply_action for state mutation.
    Add 15 tests covering all major packet types including bad checksum,
    proxy packet, border sync, screensaver mode, and LED set report.
    337 tests pass, release build clean.
    [mod.rs, packet_dispatch.rs]
2026-03-26 feat(ffi): replace C process_packet() with Rust dispatcher
    Move UART protocol dispatch from C (uart.c switch statement) to Rust
    (service::packet_dispatch via #[export_name = "process_packet"]).
    C retains only transport: DMA polling, ring buffer fetch, packet_receiver_task.
    Rust now owns the full protocol: checksum validation, type classification,
    handler dispatch for all 22 packet types.
    Remove 10 individual rust_handle_* FFI exports (now internal to Rust).
    Remove config.rs FFI wrappers (handle_api_msg, handle_api_read_all)
    that were only called from the now-removed C dispatcher.
    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
    [callbacks.rs, config.rs]
2026-03-26 chore(ffi): add traceln!() at 10 silent return points in callbacks
    FFI callbacks silently returned on null pointers and invalid input,
    making dropped packets invisible during debugging. Add crate::traceln!()
    calls at all early-return guard clauses — compiles to zero code when
    the `trace` feature is disabled.
2026-03-26 docs: document dual-core ownership model and torn-read safety
    Add Core Ownership Model block comment to Device struct with per-field
    annotations ([C0], [C1], [Shared], [Init]) documenting which core owns
    each field.
    Add SAFETY(dual-core) comments at the u64 torn-read sites:
    - lib.rs: Core1 writes core1_last_loop_pass (not atomic on M0+)
    - tasks.rs: Core0 reads it in check_system_health()
    Both torn reads are tolerable (at most one missed watchdog kick).
    Restrict get_global_device() to Core0-only via doc comment.
    [lib.rs, structs.rs, tasks.rs]
2026-03-26 test(service): add 15 edge-case tests for dispatch, hotkey, msg_bridge
    packet_dispatch: unknown type ignored, SystemControl simple path,
    heartbeat state update, firmware upgrade path, reboot path.
    hotkey_dispatch: output toggle (normal + switch_lock blocked),
    mouse_zoom/switch_lock/gaming_mode toggle with peer notification.
    msg_bridge: set_report with role=1 index, zero mouse report,
    same-output select, border halfway point, combined kbd routing.
    337 → 352 tests, all pass.
    [hotkey_dispatch.rs, msg_bridge.rs, packet_dispatch.rs]
2026-03-26 feat(service): port led_blinking_task from C to Rust
    Move LED blink state machine to Rust:
    - domain/blink.rs: pure logic (blink_step, start_blink) with 6 tests
    - service/tasks.rs: led_blink_tick() orchestrates domain + HAL
    - hal/ffi/tasks.rs: #[export_name = "led_blinking_task"] replaces C
    Extend Indicator trait: toggle() now returns bool (new LED state),
    add set_keyboard_leds() for blink-synced keyboard LED control.
    Remove led_blinking_task/blink_led from led.c, relocate blink_led
    to hal_shim.c. 358 tests pass, firmware build clean.
    [blink.rs, device.rs, hal_shim.c, mock.rs, mod.rs, pico.rs, tasks.rs, traits.rs]
2026-03-26 refactor: inline uart.c queue functions into hal_shim.c and remove uart.c
    Move _queue_packet, queue_cc_packet, queue_system_packet, queue_cfg_packet,
    queue_packet, send_value, and set_active_output from uart.c into hal_shim.c.
    Remove uart.c from the build (CMakeLists.txt).
    uart.c is now empty — all UART packet dispatch was already in Rust
    (service::packet_dispatch), and queue helpers are now in the HAL shim.
    Firmware build clean.
2026-03-26 feat(service): port process_hid_queue_task from C to Rust
    Move HID output queue → TinyUSB send logic to Rust:
    - Add HidQueue trait (peek/pop/send_hid_report) to hal/traits.rs
    - Implement in pico.rs via new hal_shim.c wrappers
    - service/tasks.rs: process_hid_queue() replaces C implementation
    - hal/ffi/tasks.rs: #[export_name = "process_hid_queue_task"]
    Add hal_hid_queue_peek/remove and hal_tud_hid_n_report C wrappers.
    Remove process_hid_queue_task from tasks.c.
    358 tests pass, firmware build clean.
    [device.rs, hal_shim.c, mock.rs, pico.rs, tasks.c, tasks.rs, traits.rs]
2026-03-26 feat(service): port packet_receiver_task from C to Rust
    Move DMA ring buffer packet reception to Rust:
    - Add DmaRx trait (dma_rx_current_pos, is_start_of_packet, fetch_packet)
    - service/tasks.rs: packet_receive_tick() replaces C packet_receiver_task
    - hal/ffi/tasks.rs: #[export_name = "packet_receiver_task"]
    Uses existing domain::packet::get_ptr_delta for ring buffer arithmetic.
    fetch_packet/is_start_of_packet still delegate to C hal_shim wrappers
    (DMA register access requires C).
    Remove packet_receiver_task + is_start_of_packet + fetch_packet from
    tasks.c. Delete empty uart.c.
    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
    [mock.rs, pico.rs, tasks.c, tasks.rs, traits.rs]
2026-03-26 refactor: inline is_start_of_packet/fetch_packet into hal_shim.c
    Move DMA ring buffer functions from tasks.c into hal_shim.c where
    their hal_ wrappers already existed. Eliminates the indirection
    (hal_shim called tasks.c, now contains the logic directly).
    request_byte remains in tasks.c (used by firmware_upgrade_task).
    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
2026-03-26 feat(service): port heartbeat_output_task fully to Rust
    Move DH_DEBUG BOOTSEL check from C heartbeat_output_task into Rust
    heartbeat_tick(). Add Watchdog::is_bootsel_pressed() trait method
    (returns false in release builds via hal_shim.c #ifdef guard).
    Replace C heartbeat_output_task with #[export_name] in Rust FFI.
    tasks.c now contains only: usb_device/host_task (TinyUSB stubs),
    firmware_upgrade_task (flash-dependent), request_byte, reboot.
    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
    [device.rs, hal_shim.c, mock.rs, pico.rs, tasks.c, tasks.rs, traits.rs]
2026-04-05 feat: add DDM version encoding and debug auto-propagate firmware
    Port 70e78a3 and 0856077 to Rust:
    - Add DDM_VERSION to CMakeLists.txt, encode as (base*100)+ddm
    - Add dh_debug Cargo feature, pass from cmake when DH_DEBUG=ON
    - Include CRC16 in heartbeat packet (data16[1])
    - Board B auto-upgrades from Board A when same version but different
    CRC (debug builds only), enabling single-board flash workflow
2026-04-05 refactor: decouple structs.h from Pico SDK types
    Replace SDK-dependent types in device_t with SDK-free equivalents:
    - queue_t → queue_opaque_t (16-byte aligned blob)
    - hid_keyboard_report_t → hid_kbd_report_t (defined in structs.h)
    - flash.h uses __has_include to conditionally include SDK header
    Add sdk_verify.h with _Static_assert to verify opaque types match
    actual SDK types (size, alignment, FLASH_PAGE_SIZE). C code accesses
    real queue_t via queue_from_opaque() inline accessor.
    This makes structs.h parseable without the Pico SDK, enabling
    bindgen-based compile-time layout verification for Rust.
    [flash.h, hal_shim.c, hid_input.h, main.h, sdk_verify.h, setup.c, structs.h, tasks.c]
2026-04-05 refactor: make hid_interface_t opaque in structs.h
    Replace hid_interface_t with hid_iface_opaque_t (932-byte aligned
    blob). Add iface_from_opaque() accessor in sdk_verify.h. Duplicate
    MAX_DEVICES/MAX_INTERFACES constants in structs.h with #ifndef guard.
    Include constants.h in structs.h for NUM_SCREENS (SDK-free header).
    structs.h now has zero SDK/TinyUSB transitive dependencies.
    [sdk_verify.h, structs.h, usb.c]
2026-04-05 refactor: replace runtime layout verify with compile-time bindgen asserts
    Remove hal_verify_device_layout() and all RUST_OFFSET_*/RUST_SIZEOF_*
    runtime exports. Layout verification is now compile-time:
    - build.rs parses SDK-free structs.h via bindgen (--target=arm-none-eabi)
    - Extracts sizeof/offsetof from generated layout tests
    - Generates device_offsets.rs with const assert statements
    - Rust build fails if Device struct doesn't match C device_t
    Also: add stddef.h to api_config.h (size_t), enable
    CMAKE_EXPORT_COMPILE_COMMANDS for IDE support.
    [api_config.h, build.rs, hal_shim.c, main.c, structs.rs]
2026-04-05 fix: rewrite build.rs parser for bindgen 0.71 layout format
    The previous parser searched for assert_eq! patterns but bindgen 0.71
    uses array-size-trick format with multiline field offsets. This caused
    device_offsets.rs to contain zero assertions — compile-time layout
    verification was silently non-functional.
    - Rewrite parser to handle bindgen 0.71 ["..."][expr - VALUEusize] format
    - Handle multiline offset expressions (field name and value on separate lines)
    - Add panic guard when no assertions are extracted
    - Add _running_fw, fw, config_mode_timer to c_to_rust_field mapping
    - Add api_config.h to rerun-if-changed
    - Remove unused bindings.rs output
    - Add _Static_assert for MAX_DEVICES, MAX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
    [build.rs, sdk_verify.h, structs.h, structs.rs]
2026-04-05 refactor: reduce MAX_INTERFACES from 12 to 4
    Most USB HID devices use 1-4 interfaces (keyboard + mouse + vendor +
    consumer). QMK keyboards max out at 4. The previous value of 12 was
    excessive and caused iface[4][12] = 44.7KB — 98.6% of device_t.
    With MAX_INTERFACES=4: iface[4][4] = 14.9KB. RAM usage drops from
    54% to 43% (29KB savings on 256KB RP2040).
2026-04-05 refactor: define 5 device sub-struct types in structs.h
    Add device_hid_t, device_config_t, device_fw_t, device_led_t, and
    device_hw_t as independent struct types above the existing device_t.
    This is a purely additive change — device_t remains unchanged.
    These types will replace device_t as independent global variables,
    enabling bindgen-based layout verification for non-SDK types and
    eliminating the hand-crafted Rust Device struct.
    [structs.h]
2026-04-05 refactor: update macros to use new global sub-structs
    Switch BOARD_ROLE, SERIAL_RX_PIN, SERIAL_TX_PIN (pinout.h) and
    CURRENT_BOARD_IS_ACTIVE_OUTPUT (constants.h) from global_state to
    global_cfg. These macros are expanded in multiple C files, so updating
    them first avoids conflicts during per-file migration.
    [constants.h, pinout.h]
2026-04-05 refactor: migrate hal_shim.c to global sub-structs
    Switch all queue operations from dev->*_queue to global_hw.*_queue,
    DMA operations from dev->dma_* to global_hw.dma_*, LED state from
    state->blinks_left to global_led.blinks_left, output/debug state to
    global_cfg.*, and UART packet queue to global_hw.uart_tx_queue.
    Function signatures retain device_t* parameter for caller compatibility
    during the transition period.
2026-04-05 refactor: migrate usb.c and usb_descriptors.c to global sub-structs
    Replace direct global_state field access with the appropriate sub-struct
    globals: global_cfg for config/flags/connection state, global_hid for
    kbd_dev_addr/kbd_instance, global_hw for iface arrays.
    Three global_state references remain where device_t* is passed to
    functions whose signatures haven't been updated yet (process_packet,
    restore_leds, blink_led).
    [usb.c]
2026-04-05 refactor: migrate led.c, hal_util.c, tasks.c, ramdisk.c to global sub-structs
    - led.c: keyboard state from global_cfg, kbd addresses from global_hid
    - hal_util.c: config load/save uses global_cfg.config and
    global_fw.page_buffer, config timer uses global_cfg
    - tasks.c: firmware upgrade state from global_fw, queues from global_hw
    - ramdisk.c: firmware state from global_fw
2026-04-05 refactor: remove shadow writes from setup.c, use global sub-structs directly
    - setup.c: initial_setup now writes only to new globals (global_cfg,
    global_hw, global_fw). DMA configure functions take no args and
    write directly to global_hw. Removed all shadow writes to legacy
    global_state.
    - hal_util.c: remove shadow-back of config in load_config.
    No C source files reference global_state anymore.
2026-04-05 refactor: define Rust sub-struct types and DeviceState bridge
    Add DeviceHid, DeviceConfig, DeviceFw, DeviceLed as #[repr(C)] structs
    matching the C sub-struct types. Add extern "C" declarations for the C
    global variables (global_hid, global_cfg, global_fw, global_led).
    Introduce DeviceState<'a> as a unified mutable view over all sub-structs,
    created from the extern globals at FFI entry points. This serves as a
    drop-in replacement for &mut Device during migration.
    Legacy Device struct is retained temporarily.
    [structs.rs]
2026-04-05 refactor: migrate Rust codebase from Device to DeviceState sub-structs
    Replace all &mut Device / &Device references across the entire Rust
    service layer and FFI with &mut DeviceState / &DeviceState, which holds
    references to the 4 independent C global sub-structs (DeviceHid,
    DeviceConfig, DeviceFw, DeviceLed).
    Field access mapping:
    - state.pointer_x → state.hid.pointer_x (HID input state)
    - state.config → state.cfg.config (configuration & flags)
    - state.fw.address → state.fw.fw.address (firmware upgrade)
    - state.blinks_left → state.led.blinks_left (LED control)
    - state.usb_connected → state.cfg.tud_connected (name aligned with C)
    FFI entry points (tasks.rs, callbacks.rs) now crea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
    [callbacks.rs, config_api.rs, fw_upgrade.rs, hotkey_dispatch.rs, hotkey_handlers.rs, integration_tests.rs]
2026-04-05 refactor: remove legacy Device struct and layout_verify
    Remove the monolithic Device struct, device_from_ptr(), get_global_device(),
    and the compile-time layout_verify module that asserted device_t field
    offsets. These are no longer needed — all Rust code now accesses the 4
    independent sub-struct globals (DeviceHid, DeviceConfig, DeviceFw,
    DeviceLed) via DeviceState.
    GLOBAL_DEVICE_PTR is retained as AtomicPtr<c_void> for PicoHal's C FFI
    calls that still accept a device_t* parameter. It will be removed once
    C function signatures are updated.
    Also remove the unused get_ptr_delta FFI wrapper (C callers migrated to
    Rust's DmaRx trait).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
    [structs.rs, util.rs]
2026-04-05 fix: update MAX_INTERFACES fallback and fix build errors
    - structs.h: update MAX_INTERFACES fallback from 12 to 4 (matches
    the actual SDK value after 6b8ea3f)
    - sdk_verify.h: update _Static_assert to expect 4
    - hal_util.c: use time_us_64() directly instead of hal_time_us_64()
    wrapper to fix implicit declaration error
    - hal/ffi/util.rs: remove unused get_ptr_delta FFI wrapper that
    referenced the removed Device struct
    Verified: full debug build (C + Rust + ARM link) passes.
    [hal_util.c, sdk_verify.h, structs.h]
2026-04-05 refactor: remove device_t* parameter from all C and Rust functions
    Strip the unused device_t* parameter from all 30+ C function signatures
    in hal_shim.c, led.c, hal_util.c, tasks.c, setup.c, and their headers.
    Update all call sites in usb.c and main.c.
    On the Rust side:
    - PicoHal becomes a unit struct (no more dev pointer)
    - All extern "C" FFI declarations drop the dev parameter
    - TaskFn signature changes from fn(*mut c_void) to fn()
    - Scheduler no longer passes dev pointer to tasks
    - rust_main_loop/rust_core1_loop take no arguments
    - Remove GLOBAL_DEVICE_PTR, set_global_device, get_global_device_ptr
    22 files changed. Full debug build (C + Rust ARM) verified.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
    [callbacks.rs, config.h, device.rs, firmware.h, hal_shim.c, hal_util.c, hid_input.h, lib.rs]
2026-04-05 refactor: remove device_t, task_t, and global_state
    Remove the legacy device_t typedef (62 lines), task_t typedef, and the
    global_state variable. All code now uses the 5 independent sub-struct
    globals (global_hid, global_cfg, global_fw, global_led, global_hw).
2026-04-05 refactor: switch build.rs to sub-struct layout verification
    Replace the old device_t-based bindgen assertion with per-sub-struct
    verification: device_hid_t (50B), device_config_t (192B), device_fw_t
    (284B), device_led_t (8B). Each struct gets size, alignment, and all
    field offset assertions.
    device_hw_t is excluded (contains SDK-dependent opaque types).
    Fix extract_value parser to scope rfind within semicolon boundary,
    preventing it from matching values from adjacent assertions.
    [build.rs, structs.rs]
2026-04-05 refactor: replace hand-crafted Rust structs with bindgen-generated types
    build.rs now generates struct definitions via bindgen for all 4
    sub-structs (device_hid_t, device_config_t, device_fw_t, device_led_t)
    plus their nested types (config_t, output_t, screensaver_t, etc.).
    structs.rs includes the generated types and re-exports them with Rust
    naming conventions (e.g., device_hid_t → DeviceHid, config_t → Config).
    This eliminates the hand-crafted struct definitions that were the root
    cause of the align(8) layout bug. Layout correctness is now guaranteed
    by construction, not just assertion.
    Rename running_fw → _running_fw to match C field name in bindgen output.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
    [build.rs, config_api.rs, msg_handlers.rs, structs.rs, tasks.rs]
2026-04-05 chore: add post-build ELF usage report (FLASH/RAM actual usage)
    Add misc/elf_usage.py that reads __flash_binary_end linker symbol and
    arm-none-eabi-size output to report actual FLASH and RAM usage
    pre-padding. The linker's --print-memory-usage always shows FLASH at
    100% due to fixed partition sizing, so this gives accurate numbers.
2026-04-05 chore: suppress GNU-stack executable stack linker warning
    Add --no-warn-execstack linker option to suppress the deprecated
    .note.GNU-stack warning from arm-none-eabi-ld.
2026-04-05 refactor: move USB callback logic from C to Rust
    Move all business logic out of TinyUSB callbacks in usb.c into Rust
    (callbacks.rs). C retains only thin stubs that resolve opaque iface
    pointers and delegate to Rust via FFI.
    Callbacks migrated:
    - tuh_hid_mount_cb → rust_on_hid_mount (protocol negotiation, config checks)
    - tuh_hid_umount_cb → rust_on_hid_umount (connection state, iface clear)
    - tuh_hid_report_received_cb → rust_on_hid_report_received (device_idx, dispatch)
    - tuh_hid_set_protocol_complete_cb → rust_on_hid_set_protocol_complete
    - tud_hid_set_report_cb → rust_on_tud_set_report (config packets, LED handling)
    Also adds TinyUSB host shims (hal_tuh_hid_*) in hal_shim.c so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
    [callbacks.rs, constants.rs, device.rs, hal_shim.c, hid.h, usb.c]
2026-04-05 fix: resolve all clippy warnings for ARM target
    - Remove unnecessary mut bindings (callbacks.rs, lib.rs)
    - Remove dead constant DMA_RX_BUFFER_SIZE (tasks.rs)
    - Simplify identical if/else blocks (actions.rs)
    - Collapse nested if statements (hid_classify.rs)
    - Add Default impls (ParserState, ParseResults, PongState, JitterState, PicoHal)
    - Add is_empty() for ParseResults (clippy::len_without_is_empty)
    - Use copy_from_slice instead of manual loop (hid_routing.rs)
    - Use contains() instead of iter().any() (kbd_state.rs, keyboard.rs)
    - Allow too_many_arguments on update_mouse_position (mouse_logic.rs)
    - Add Safety doc for iface_from_ptr (structs.rs)
    - Remove implied supertrait bounds (packet_dispa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
    [actions.rs, callbacks.rs, hid_classify.rs, hid_parser.rs, hid_routing.rs, integration_tests.rs, kbd_state.rs, keyboard.rs]
2026-04-05 refactor: move restore_leds and set_keyboard_leds from C to Rust
    Rust provides #[export_name] implementations for restore_leds and
    set_keyboard_leds. C led.c function bodies removed. New C HAL shims
    hal_gpio_put_led and hal_tuh_hid_set_report wrap SDK calls.
    This eliminates all global_cfg references from led.c.
2026-04-05 refactor: move load_config, save_config, reset_config_timer to Rust
    Rust reads flash via hal_flash_read_config shim, validates magic/
    version/checksum, and falls back to default_config. save_config
    computes CRC32 and writes via hal_flash_write_config shim.
    New C HAL shims: hal_flash_read_config, hal_flash_write_config.
    C hal_util.c function bodies removed.
    This eliminates all global_cfg references from hal_util.c.
    [callbacks.rs, device.rs, hal_shim.c, hal_util.c]
2026-04-05 refactor: decouple setup.c from global_cfg
    Introduce rust_init_config() to set config_mode_active, board_role,
    and core1_last_loop_pass from SDK-probed values. serial_init() and
    pio_usb_host_config() now take explicit parameters instead of reading
    global_cfg. SERIAL_*_PIN macros no longer needed.
    This eliminates all global_cfg references from setup.c.
    [callbacks.rs, setup.c, setup.h]
2026-04-05 refactor: remove all C references to global_cfg
    Remove BOARD_ROLE, OTHER_ROLE, SERIAL_*_PIN, CURRENT_BOARD_IS_ACTIVE_OUTPUT
    macros and the extern declaration from misc.h.
    grep -rn 'global_cfg' src/ now returns zero results (excluding comments).
    global_cfg is fully Rust-owned and C code no longer accesses it.
    [constants.h, pinout.h]
2026-04-05 refactor: move device_config_t from C header to Rust-only struct
    Remove device_config_t typedef from structs.h. DeviceConfig is now
    hand-crafted in Rust with compile-time size/align assertions matching
    the former C layout (192 bytes, 8-byte aligned).
    config_t remains in C headers (flash layout, bindgen-generated).
    build.rs updated to explicitly allowlist config_t.
2026-04-05 refactor: make DeviceConfig fully Rust-native
    Remove #[repr(C)], #[no_mangle], and size assertions from DeviceConfig.
    Compiler is free to optimize field layout. Add Default derive.
    Config sub-struct remains repr(C) via bindgen (flash layout).
2026-04-05 refactor: fix layer inversion — extract business logic from HAL callbacks
    Move business logic out of hal/ffi/callbacks.rs into proper layers:
    - domain/config.rs: DeviceConfig struct, GLOBAL_CFG static, config
    load/save/init/timer logic with ConfigFlash trait
    - service/usb.rs: HID mount/umount, descriptor selection, LED report
    - service/led.rs: sync_indicators (board + keyboard LED sync),
    send_kbd_led_report
    - service/output.rs: switch_output (output change + indicator sync)
    callbacks.rs now contains only thin FFI wrappers that convert raw
    pointers to Rust types and delegate to service/domain functions.
    [callbacks.rs, config.rs, led.rs, mod.rs, output.rs, pico.rs, structs.rs, usb.rs]
2026-04-05 refactor: move global_hid, global_led to Rust-only; delete led.c
    global_hid and global_led are now Rust-owned static muts (GLOBAL_HID,
    GLOBAL_LED). C definitions and extern declarations removed.
    blink_led, toggle_led, hal_toggle_led ported to Rust. led.c deleted
    entirely — all LED functions now in Rust (callbacks.rs + service/led.rs).
2026-04-05 fix: call rust_init_config before multicore_launch_core1
    Core 1 starts rust_core1_loop which reads GLOBAL_CFG. Previously
    rust_init_config (setting board_role, config_mode_active) was called
    after core1 launch, causing a brief window where core1 could see
    zeroed config state. Move init before launch to eliminate the race.
    [setup.c]
2026-04-05 feat(debug): disable watchdog in debug builds
    Skip watchdog_enable() when DH_DEBUG is defined — watchdog interferes
    with diagnostic LED blinks and CDC serial output during development.
    Also disable watchdog on layout verify failure (all builds) so error
    code blinks are visible even when N×200ms exceeds the 500ms timeout.
    [setup.c]
2026-04-05 feat(debug): add LED diagnostics framework
    Structured LED blink pattern system for boot-stage tracking, error
    indication, and runtime events. Only active in dh_debug builds.
    - domain/led_pattern.rs: DiagEvent enum + LedPattern table
    Boot stages 1-7, DeviceConnected, Panic, HardFault patterns
    - callbacks.rs: diag_led() blocking FFI (busy-wait + GPIO)
    - setup.c: diag_led(1..7) at each init stage
    GPIO LED init moved before load_config so patterns are visible
    - lib.rs: panic handler uses diag_led(0xF0) for rapid continuous blink
    If boot hangs, the last LED blink count indicates which stage failed.
    [callbacks.rs, led_pattern.rs, lib.rs, mod.rs, setup.c]
2026-04-05 feat(debug): separate LED diagnostics into Always and DebugOnly levels
    BootComplete, Panic, HardFault, DeviceConnected patterns play in all
    builds (Always). Detailed boot stage patterns (1-6) play only in
    debug builds (DebugOnly). diag_led() checks pattern level at runtime.
2026-05-10 chore(clippy): replace explicit counter loop with zip iterator
    clippy 1.95 promotes explicit_counter_loop from warn to deny in our
    -D warnings setup. Rewrite extract_bit_variable's parallel index
    counter as `(start_bit..).zip(usage_min..=usage_max)`.
    [hid_report.rs]
2026-05-10 fix(packet): restore Rust packet_receive_tick from no-op placeholder
    packet_receive_tick was reduced to a stub during the device_t →
    DeviceState refactor, with a comment claiming the C side still owned
    the packet receiver — but the C packet_receiver_task had been deleted
    in 127e7dd ("port packet_receiver_task from C to Rust") and the
    #[export_name = "packet_receiver_task"] Rust wrapper now shadows the
    slot. Net effect: no UART packet was ever dispatched on either board,
    so heartbeats / mouse / keyboard / DebugLog forwarding all silently
    failed at runtime (tests still passed because the stub trivially
    returned).
    Re-implement the loop from the original 127e7dd version, this time
    without d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
    [device.rs, hal_shim.c, mock.rs, pico.rs, tasks.rs, traits.rs]
2026-05-10 feat(packet): add PacketType::DebugLog = 26 for peer log channel
    Reserve packet type 26 for the upcoming peer debug log channel that
    forwards A board's logs to B board's CDC over UART. The dispatcher
    falls through to the no-op case in dispatch_simple, so receiving a
    DebugLog packet without a handler is safe and silently dropped.
2026-05-10 feat(peer-log): add Pico SDK spinlock shim for cross-core MPSC ring
    Expose three C wrappers (peer_log_lock_init / acquire / release) over
    a single hardware spinlock claimed during initial_setup(). The Rust
    service::peer_log module will use these to guard a multi-producer
    single-consumer byte ring buffer accessed from both cores and ISRs.
    The shim is a no-op stub when DH_DEBUG is off, so release builds stay
    free of the spinlock and pull in zero extra cost.
2026-05-10 feat(peer-log): add ring buffer + line-prefix push API + FFI export
    New module service::peer_log provides a 1KB cross-core MPSC byte ring
    buffer guarded by the Pico SDK spinlock added in the previous commit.
    Three entry points:
    - push(bytes): local producer. Injects the board-role prefix
    ("[A] " or "[B] ") at every line start, tracked via last_was_newline
    state. Used by Rust traceln!() and the C dh_debug_printf forwarder
    (peer_log_push FFI export).
    - push_received(bytes): bytes received over UART from the peer board.
    Strips NUL padding but skips prefix injection (sender already
    embedded the [role] tag).
    - pop_byte() / pop_chunk_8(allow_partial): consumer side, used by the
    drain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
    [mod.rs, peer_log.rs]
2026-05-10 feat(peer-log): forward dh_debug_printf to peer_log ring buffer
    Replace the inline cdc_write_str path with a single peer_log_push()
    call so all formatted debug output (including TinyUSB's
    CFG_TUSB_DEBUG_PRINTF=dh_debug_printf chatter) flows through the Rust
    ring buffer. The drain task added next routes those bytes either to
    UART (board A → forward to peer) or to local CDC (board B).
    Also tighten dh_debug_printf to skip the second pass when vsnprintf
    returns nothing or got truncated, and move va_end before the
    formatting work for clarity.
    [hal_util.c]
2026-05-10 feat(peer-log): add 1kHz drain task with role-based routing
    debug_log_flush_task runs on Core0 at 1kHz and dispatches based on
    the local board role:
    - OUTPUT_A: drain ring 8 bytes at a time, packetize as DebugLog
    (PacketType 26), and queue to UART via the existing queue_packet
    shim. Partial chunks flush every tick (NUL-padded; receiver strips
    NUL). The 1ms-bounded latency keeps short messages from sitting in
    the ring while UART is otherwise idle.
    - OUTPUT_B: bulk-pop bytes into a 64-byte stack buffer and write to
    tud_cdc_write. Skips the drain entirely when the host CDC isn't
    connected, so logs accumulate in the ring (up to RING_SIZE = 1KB,
    oldest-drop on overflow) and surfac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
    [hal_shim.c, lib.rs, peer_log.rs]
2026-05-10 feat(peer-log): receive DebugLog packets into local ring buffer
    Wire DispatchAction::DebugLog in service::packet_dispatch to feed
    incoming bytes through peer_log::push_received(). The sender already
    embedded the [A] prefix, so the receiver only needs to strip NUL
    padding (handled inside push_received). The bytes then merge into
    B's single ring buffer alongside its own local logs and reach CDC
    through the existing drain task.
    This closes the loop: A's dh_debug_printf -> peer_log_push (A's ring)
    -> debug_log_flush_task (drain to UART) -> packet_receiver_task on B
    -> dispatch_packet -> push_received (B's ring) -> debug_log_flush_task
    on B (drain to CDC).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
2026-05-10 feat(peer-log): emit boot banner with role + config-mode
    Single dh_debug_printf right after rust_init_config so every boot
    leaves a "[A|B] boot role=A config=0\n" line in the peer log. Useful
    for confirming role auto-probe and tracing reboots in the unified
    B-side console.
    [setup.c]
2026-05-10 docs: bootstrap CONTEXT.md glossary and initial ADRs (0001-0003)
    Captures the domain language so future contributions reference one
    canonical vocabulary instead of the overlapping historic terms
    (upstream/downstream/peer over frontend/backend, output vs screen,
    packet vs report vs message vs cfgmsg, local/remote switch, etc.).
    Three deliberate architectural decisions are recorded in docs/adr/:
    - 0001 decision-action split with segregated HAL traits
    - 0002 core split: consumers on core0, producers on core1
    - 0003 two-stage firmware upgrade with peer auto-propagation
    Known code-vs-canonical mismatches are listed under "Flagged
    ambiguities" as a cleanup backlog (NUM_SCREENS naming, gaming_mod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
2026-05-10 feat(passthrough): add domain modules and struct foundations
    Add passthrough.rs (HID++ protocol, descriptor capture) and
    key_remap.rs (CapsLock remapping) from feature/passthrough-rust-port.
    Extend config_t with passthrough fields, device_led_t with blink mode,
    DeviceConfig with switch_requested, and LED blink constants.
2026-05-10 feat(hal): add UsbHost, PassthroughHal traits and implementations
    Add UsbHost (send_set_report, get_upstream_vid_pid, receive_report)
    and PassthroughHal (build_config_desc, clear_config_desc) traits.
    Add device_disconnect/device_connect to UsbDevice trait.
    Implement all in PicoHal (C FFI) and MockHal (test).
    Add global PassthroughState and config descriptor buffer in FFI layer.
2026-05-10 feat(service): add passthrough_service adapted to DeviceState
    Port passthrough_service.rs from feature/passthrough-rust-port,
    converting Device references to DeviceState sub-struct accessors
    (cfg, hid, led). Includes 14 unit tests covering task lifecycle,
    USB callbacks, and SET_REPORT handling.
2026-05-10 feat(ffi): wire passthrough and remap into scheduler and callbacks
    Register passthrough_task (100Hz) and remap_engine_tick_task (1000Hz)
    in Core0 scheduler. Hook passthrough into USB mount/umount/report/
    set_report callbacks. Add PT_WAIT slow-pulse LED mode.
    Add C-side TinyUSB wrappers for disconnect/connect/VID-PID/SET_REPORT
    and dynamic config descriptor builder in hal_shim.c.
2026-05-10 feat(passthrough): hold device disconnected at boot until host capture
    Call tud_disconnect() right after tud_init() when passthrough is
    enabled, so the host never sees the default DeskHop descriptors before
    the upstream USB device is enumerated. The device side is re-attached
    later by passthrough_service when captured descriptors stabilize or
    the bring-up fallback fires.
    Add rust_passthrough_should_delay() FFI bridge so initial_setup can
    read passthrough_enabled from the Rust-owned config without C linkage
    to GLOBAL_CFG.
    [setup.c, tasks.rs]
2026-05-10 feat(passthrough): expose captured USB descriptors on device side
    When passthrough is active, route the three USB descriptor callbacks
    to the captured upstream data instead of the static DeskHop tables:
    - rust_get_device_descriptor: patch upstream VID/PID into a static
    copy of desc_device so the host sees the real device identity.
    - rust_get_hid_report_descriptor: return the captured report
    descriptor for instances at or above ITF_NUM_PT_BASE.
    - rust_get_configuration_descriptor: return the dynamically built
    config descriptor produced by passthrough_hal_build_config_desc().
    Config-mode descriptors keep priority so the web config UI still
    works while passthrough is engaged.
    Co-Author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
2026-05-10 feat(passthrough): enable by default and relax bring-up policy
    Flip DEFAULT_CONFIG.passthrough_enabled to 1 so a fresh flash boots
    with passthrough engaged.
    Two debug relaxations in passthrough_service for hardware bring-up,
    both clearly marked DEBUG in the source:
    - Fallback connect after 3s ignores receiver presence so we can
    verify hal.device_connect() re-attaches the device side after the
    boot-time tud_disconnect().
    - Activation no longer requires a vendor/HID++ interface, so
    non-Logitech mice can also exercise the descriptor path on the rig.
    Bump RECONNECT_DELAY_US from 200ms to 500ms — observed hosts need
    the longer gap to detect removal before re-enumeration.
    Co-Authored-B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
    [config.rs, passthrough_service.rs]
2026-05-10 docs(passthrough): document PT_STATE cross-core race
    The "single core access only" comment above PT_STATE was inherited from
    DBG_COUNT/LAST_POINTER_MOVE and carried through the passthrough series
    without re-evaluation. PT_STATE is actually mutated from both cores:
    Core0: passthrough_task scheduler, rust_on_tud_set_report
    Core1: rust_on_hid_mount / umount / report_received
    Readers (Core0 USB device descriptor callbacks) hit data being mutated
    on Core1 — torn descriptor reads and use-after-compaction are real but
    narrow race windows. ADR-0002's "no contention" invariant for cross-core
    data does not hold here.
    Replace the misleading comment with the actual access boundaries and
    note th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
    [tasks.rs]
2026-05-10 fix(hal): pre-check buffer bounds in passthrough config descriptor
    The previous overflow check ran AFTER all writes, so by the time it
    detected `off > 280` the buffer had already been trampled (CWE-787).
    On RP2040 with stack and heap sharing SRAM this is undefined behavior,
    not just a wasted descriptor.
    Restructure as pre-check: each segment write tests `off + segment_len
    > buf_size` and bails out via `goto overflow` before touching memory.
    The 280 magic number is replaced by a buf_size parameter sourced from
    MAX_CONFIG_DESC_SIZE on the Rust side, eliminating the silent coupling
    between the C constant and the Rust buffer declaration.
    Drop the dead `ifaces` parameter — the implementation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
    [device.rs, hal_shim.c, mod.rs]
2026-05-10 refactor(passthrough): split HID++ scan state machine into own module
    The scan state machine is a debug-hotkey-only feature that lived
    alongside production passthrough logic in domain/passthrough.rs (1168
    LOC). It accounted for ~120 LOC of code plus 7 tests, all unrelated to
    the steady-state passthrough flow (descriptor capture, HID++ event
    conversion, lifecycle).
    Move build_scan_query, start_hidpp_scan, scan_step, handle_scan_response
    plus SCAN_TIMEOUT_US and HIDPP_SCAN_MAX_FEATURES into a new
    domain/passthrough_scan.rs. Tests move with their functions.
    The HidppScan and HidppScanState types stay in domain/passthrough.rs
    because they are fields of PassthroughState. The new module imports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
2026-05-10 fix(passthrough): force RELATIVE mode in HID++ to mouse converter
    The inactive-output HID++→mouse conversion path branched on
    relative_mouse || gaming_mode and fell back to ABSOLUTE if both were
    false. That path injected dev.hid.pointer_x / pointer_y from a mouse
    pipeline that's been bypassed entirely once passthrough activates —
    the values would be stale or zero, producing cursor jumps on the
    peer side.
    Activation already forces gaming_mode=true so the ABSOLUTE branch was
    unreachable in practice, but a stale gaming_mode toggle (web config,
    hotkey, or peer message) during an active passthrough session would
    have re-enabled the broken path.
    Pin to RELATIVE unconditionally — the inacti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
    [passthrough_service.rs]
2026-05-10 feat(passthrough): add absolute safety timeout with late-capture lockout
    Today the bring-up DEBUG block calls device_connect() at 3s regardless
    of receiver presence so the device side reattaches even when no upstream
    appears. After that block is reverted at merge time, a user with
    passthrough_enabled=1 but no recognized vendor receiver would see the
    device side stay disconnected forever — the only recovery path is
    reflashing via BOOTSEL because config-mode hotkey requires the keyboard
    to enumerate first.
    Add an absolute safety net: if no vendor interface has appeared upstream
    by ABSOLUTE_TIMEOUT_US (10s), fall back to default DeskHop descriptors
    and set pt.gave_up. The gave_up flag locks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
    [passthrough.rs, passthrough_service.rs]
2026-05-10 feat(passthrough): SmartShift double-click triggers output switch
    The previous code treated every SmartShift button press as an
    output-switch trigger via dev.cfg.switch_requested = true. Since
    SmartShift is the wheel-mode toggle button and users press it many
    times during normal scrolling, every press would have flipped A↔B,
    making the receiver effectively unusable.
    Replace with a defer-and-conditional-forward state machine:
    - First SmartShift press buffers the event and starts a window
    sized by cfg.config.smartshift_double_click_ms (default 350ms).
    - Second SmartShift press within the window discards the buffered
    events, sets switch_requested, and marks the upcoming release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
    [config.rs, mock.rs, passthrough.rs, passthrough_service.rs]
2026-06-05 feat(passthrough): re-enumerate via runtime disconnect→reconnect cycle
    Boot the device side as the default DeskHop and, once a host receiver is
    captured and stabilized, force the PC to re-enumerate with the passthrough
    composite by calling tud_disconnect() and reconnecting RECONNECT_DELAY_US
    later from a connected state.
    Drop the abandoned boot-time approach: tud_disconnect() right after tud_init()
    (via rust_passthrough_should_delay) and the 3s DEBUG bring-up fallback connect.
    Most PC USB stacks ignore the brief boot-time SE0 and keep the cached
    enumeration, so an explicit disconnect→reconnect from a connected state is what
    actually triggers the host to re-fetch descriptors.
    Co-Authore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
    [passthrough_service.rs, setup.c, tasks.rs]
2026-06-05 fix(passthrough): size CFG_TUD_HID for composite and guard the HID budget
    The passthrough composite declares 2 DeskHop base HID interfaces plus one HID
    interface per captured upstream interface (2 + iface_count instances). With
    CFG_TUD_HID=3 a receiver exposing >=2 interfaces (e.g. a Logitech receiver:
    keyboard + mouse + HID++) needs 4-5 HID instances, so hidd_open() runs out of
    _hidd_itf[] slots, process_set_config() fails, and SET_CONFIGURATION stalls on
    re-enumeration. The mount callback never fires, tud_connected stays false, the
    passed-through mouse is dead and the LED is stuck in LED_BLINK_PT_WAIT. Boot
    enumeration was fine because the default config declares only 2 HID interfaces.
    Ra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
    [hal_shim.c, mock.rs, passthrough_service.rs, tusb_config.h]
2026-06-05 feat(hal): widen HID output queue to carry full passthrough reports
    hid_generic_pkt_t.data was sized to RAW_PACKET_LENGTH (12B, shared with the UART
    packet format), which truncates passthrough reports — a HID++ long report is 20
    bytes. Decouple it: add HID_REPORT_DATA_MAX (32) and size data[] to it.
    Add hal_queue_hid_report() and HidQueue::queue_hid_report() so a Core1 host
    callback can hand a device-bound report to the existing Core0 process_hid_queue
    sender instead of calling tud_hid_n_report directly (which races the device
    stack across cores). The mock records queued reports for tests.
2026-06-05 fix(passthrough): keep all USB device-stack access on Core0
    The PIO-USB host (tuh_task) runs on Core1; the native device (tud_task) on
    Core0. TinyUSB is not thread-safe across cores and nothing locks tud_*/tuh_*,
    so touching the device stack from a Core1 host callback races tud_task and
    hangs Core1 (observed: core1_last_loop_pass freezes => mouse dead). Audited the
    whole passthrough path and moved every device-stack access off Core1:
    - on_report_received and the SmartShift flush now hand device-bound reports to
    the Core0 process_hid_queue sender via queue_hid_report instead of calling
    tud_hid_n_report directly.
    - on_device_unmount only flags pt.disconnect_requested; passthrough_task
    p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
    [callbacks.rs, lib.rs, passthrough.rs, passthrough_service.rs, tasks.rs]
2026-06-05 fix(peer_log): translate LF to CRLF for serial-terminal display
    Rust peer_log lines were emitted with a bare '\n', so the `[pt]` traces
    staircased in a raw serial terminal (LF moves down without returning to column
    0). The C dh_debug_printf path already does this translation; mirror it in
    push_local so all locally-produced log lines get CRLF. The `prev != '\r'` guard
    avoids doubling CR for input (e.g. the C heartbeat) that already carries it.
    [peer_log.rs]
2026-06-05 feat(debug): surface Core0 loop timestamp (c0) in heartbeat
    The debug heartbeat showed only c1 (core1_last_loop_pass), so Core0 loop health
    was only implicit (the line printing at all proves Core0 ran). Add a symmetric
    core0_last_loop_pass, stamped each main-loop pass in rust_main_loop just like
    Core1 does, and print it as `c0` alongside `c1`. Makes both cores' loop rate /
    liveness visible — useful for spotting a slow (not just hung) core.
2026-06-05 fix(passthrough): defer upstream keyboard-LED sync to Core1
    sync_leds() sends the upstream keyboard's LED state via tuh_hid_set_report (host
    stack). It was reachable from Core0 contexts — the keyboard-LED tud SET_REPORT,
    config-vendor OutputSelect/KbdSetReport packets, and the SmartShift-driven
    output switch — so it could race tuh_task on Core1 and hang it.
    Gate the host send by core: send_kbd_leds_xcore() sends directly when on Core1
    (get_core_num()==1) and otherwise flags leds_resync_pending. led_blink_tick
    (Core1) drains the flag and performs the real send, so the keyboard-LED report
    always leaves on the host-stack core. ~33ms worst-case latency, imperceptible
    for indicator LEDs.
    Co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
    [callbacks.rs, device.rs, hal_shim.c, structs.rs, tasks.rs]
2026-06-05 docs(passthrough): note Core1 ifaces-mutation torn-read as a known limitation
    on_device_mount mutates ifaces[]/iface_count on Core1 while the device
    descriptor callbacks read them on Core0. In the normal flow captures stabilize
    before the activation-driven re-enum, so they don't overlap; only a very fast
    upstream re-plug racing host enumeration could. The full fix (serialize
    mount/umount to Core0 via an event queue) re-architects the enumeration path
    and is deferred until a concrete corruption symptom appears. Documented inline
    so the trade-off is explicit.
    [passthrough_service.rs]
2026-06-05 fix(peer_log): CRLF the overflow sentinel too
    The "[peer_log overflow]" sentinel is written directly into the ring (it
    bypasses push_local's LF→CRLF translation), so it staircased in the serial
    terminal like the other lines did before. Emit it with \r\n.
    [peer_log.rs]
2026-06-05 feat(led): single-authority board LED with activity flicker
    Make led_blink_tick (Core1) the sole driver of the on-board LED and give it a
    clear steady state, fixing the "active board LED sometimes off" bug and adding
    an activity indicator:
    - Running steady: active board (active_output == board_role) LED on, inactive
    off. Previously the idle branch was a no-op, so after a PT_WAIT pulse or blink
    the LED was left wherever the last toggle put it (often off). Now it is driven
    every tick from is_active_output(), so it always settles correctly — and no
    longer depends on onboard_led_state, which the PT_WAIT pulse hijacks as its
    phase.
    - HID activity (mouse/keyboard/HID++): a short OFF b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
    [callbacks.rs, lib.rs, mock.rs, pico.rs, structs.rs, tasks.rs, traits.rs]
2026-06-05 fix(passthrough): detect SmartShift double-click in divertedButtons events
    The SmartShift double-click → output switch only recognized the HID++
    analyticsKeyEvent shape (fn=2). An MX Master actually emits the wheel-mode key
    as a divertedButtonsEvent (fn=0) — a bitmap of pressed CIDs — when the button
    is diverted by Options+, so is_smartshift_event never matched and the
    double-click did nothing (config/event-shape dependent, not a debug build
    issue; confirmed via the [pt] key c=c4 fn=00 trace).
    Detect both shapes: is_smartshift_press is true for fn=2 action-press OR fn=0
    with 0xC4 in the bitmap; add is_smartshift_release (fn=2 action-release, or fn=0
    bitmap without 0xC4) used in the po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
    [passthrough.rs, passthrough_service.rs]
2026-06-05 fix(led): flicker the active board on its own HID output
    The activity stamp was only set in rust_on_hid_report_received (the board with
    the receiver/dongle). When the active output is the OTHER board, reports arrive
    there over UART and that board never sees a host-report callback, so its LED
    stayed solid on during use.
    Stamp last_hid_activity_us on the active board when it actually sends a report
    to its host: send_pending_kbd/mouse and process_hid_queue now return whether a
    report was sent, and the Core0 queue-drain tasks mark activity on success. The
    receive-side stamp is kept too, so whichever board is active flickers correctly.
    [tasks.rs]
2026-06-05 feat(passthrough): richer, active-independent [pt] debug logging
    Two logging improvements driven by real debugging on the dual-board rig:
    - Log regardless of active output: the [pt] key (HID++ control) and [pt] btn
    (mouse button) traces were emitted only inside the active-output forward
    branch, so when the dongle's board was inactive (the other board active) no
    key/button info appeared. Move both before the is_active gate — they now log
    on the receiver board whichever output is active. (The state-based traces —
    capture/activate/reconnect/unmount/safety_net/host_tx — were never gated.)
    - Enrich content via a small no_std LogBuf formatter: capture now logs
    addr/inst/proto/l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
2026-06-06 fix(passthrough): route inactive-output HID++ input to the peer board
    In the always_passthrough vendor block, HID++ input events converted to a
    mouse report on the INACTIVE output were sent via push_mouse_report, which
    always queues to the LOCAL host. So when the peer board was the active
    output, the mouse wheel and HID++ extra buttons (Back/Forward, HiRes
    scroll) landed on this inactive board's host instead of the active one —
    despite the comment already stating "convert HID++ -> mouse for peer
    routing".
    Use route_mouse (active-aware: local queue when active, UART MouseReport
    packet to the peer when inactive) for both the button-change and the
    converted-motion paths. The active-output pa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
    [passthrough_service.rs]
2026-06-06 fix(remap): stamp TAP_HOLD press time so the hold path can fire
    remap_engine_process set the press timestamp to 0 with a "caller must set
    via tick" note, but remap_engine_tick only advances Waiting->Held when
    timestamp > 0 — so the hold threshold never elapsed and the hold action
    never triggered. Take now_us and stamp the press time on Idle->Waiting.
    Also raise TAP_HOLD_DEFAULT_US 250ms -> 350ms for a more comfortable
    tap/hold split. Update the test call sites for the new signature.
    [key_remap.rs]
2026-06-06 feat(remap): wire CapsLock remap into the keyboard pipeline
    The remap engine was initialised and ticked but never fed key reports
    (remap_engine_process had no production caller), so the CapsLock TAP_HOLD
    remap (tap -> LANG1 / Shift+Space, hold -> CapsLock) never ran.
    process_keyboard_report now drives the engine: it skips the remap when the
    report is a consumed hotkey, so LCtrl+CapsLock (OutputToggle) still fires on
    the original report; otherwise it runs remap_engine_process to strip the
    trigger and advance the state machine. remap_engine_tick_task now injects the
    hold-action keys via remap_engine_get_active_output when an entry enters Held
    — without it the hold produced no output. Tap/ho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
    [callbacks.rs, tasks.rs]
2026-06-06 feat(debug): build-time-sized bidirectional peer_log ring
    The single 1KB ring drained one-way (A -> UART -> B -> B's CDC), so all
    logs only surfaced on board B's CDC — unusable when B sits on a host you
    can't read (e.g. an Android tablet on the device port).
    Split into two rings per board: OUT_RING (local + peer-received logs ->
    own CDC) and TX_RING (local logs -> peer over UART; received logs are
    never re-forwarded, so no loop). Both boards forward AND output, so
    EITHER board's CDC now shows the full [A]+[B] stream.
    OUT_RING is sized at LINK TIME to fill the RAM left after .bss: a new
    .log_ring section (misc/memory_map.ld) placed before .heap, gated by
    --defsym=__log_ring_enabled=1 (DH_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
2026-06-06 feat(debug): instrument heap usage and warn before exhaustion
    The log ring caps malloc at __LOG_HEAP_RESERVE bytes, so a runaway heap
    would crash silently at boot. Expose mallinfo arena/in-use plus the heap
    ceiling (__StackLimit - __end__) via hal_heap_{arena,inuse,limit}. The
    debug heartbeat now prints heap=<inuse>/<arena>/<limit>, and a one-shot
    "[heap] LOW arena=.. limit=.." warning fires when the arena reaches 75%
    of the limit — early diagnosis instead of a silent crash. Measured peak
    arena is ~16k vs the 32k reserve, so ample headroom.
    [callbacks.rs, device.rs, hal_shim.c]
2026-06-06 refactor(debug): unify log format via dlog
    Debug logs were ad-hoc: passthrough used a local LogBuf "[pt] ..." formatter,
    the heartbeat and heap warning used dh_debug_printf, each with its own shape.
    Add a single dlog builder (no_std, peer_log-backed) that emits a normalized,
    column-aligned line: "<sec>.<ms> <LVL> <subsys>: <event> k=v" (the board [A]/[B]
    tag is still prepended by peer_log). Levels I/W/E; subsys is a short module tag
    (pt, hb, heap, ...). Migrate the passthrough [pt] logs, the heartbeat (hb), and
    the heap warning (heap) to dlog and delete the old LogBuf. No behavior change —
    only formatting; all logs still flow through the peer_log ring.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
    [callbacks.rs, dlog.rs, mod.rs, passthrough_service.rs]
2026-06-06 fix(debug): don't drop log bytes the CDC/UART can't accept yet
    A burst (the boot HID descriptor dump is a few KB at once) garbled the
    forwarded/printed log: lines merged and truncated mid-stream.
    Two sinks silently dropped bytes already popped from the ring:
    - flush_to_cdc popped 64 bytes then called tud_cdc_write, which writes
    only what the CDC TX FIFO (64B) can take when the host reads slowly —
    the rest was lost. Now it pops at most peer_log_cdc_write_avail() bytes
    and leaves the remainder in OUT_RING for the next tick.
    - flush_to_uart drained the whole TX ring into the UART queue at once;
    with the queue empty at boot it streamed a full-rate burst that
    overran the peer's 1KB U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
    [device.rs, hal_shim.c, peer_log.rs]
2026-06-06 feat(debug): system-level HID descriptor dump + USB lifecycle logs
    Decode every mounted HID interface's report descriptor into a readable,
    report-oriented dump (subsys `hid`), at the system mount path so it covers
    all devices, not just passthrough-captured ones. A pure decoder
    (domain/hid_descdump.rs) walks the short-item structure and yields items;
    the formatter accumulates globals (page/size/count/logical) while locals
    (usages, usage min/max) reset after each Main item, collapsing each
    Input/Output/Feature to one line and showing collection nesting via
    2-space indentation. Common usage pages/usages are named (unknown -> hex).
    The dump + its helpers are #[cfg(feature="dh_debug")] so release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
    [callbacks.rs, hid_descdump.rs, mod.rs]
2026-06-06 feat(debug): dump the tud composite descriptor on mount
    On each tud mount, decode the configuration descriptor WE present to the
    host (default DeskHop or the passthrough-rebuilt composite) into readable
    `usb tud ...` lines — interfaces (class/sub/proto/#eps) and endpoints
    (addr/dir/type/mps/interval). We own these bytes, so it is a synchronous
    in-memory walk (no control transfer, no host-stack involvement). Lets us
    verify the re-presented composite at boot and across re-enumerations.
    DH_DEBUG-only; compiled out of release.
2026-06-06 fix(debug): make the CDC log a replayable scrollback
    OUT_RING was drained destructively, so bytes left the ring the moment
    tud_cdc_connected() (DTR) went true — before a human terminal was
    actually reading. A terminal that attached late, or reattached after the
    passthrough re-enumeration, caught the stream mid-line and the boot
    history was already gone, no matter how large the ring was.
    Turn OUT_RING into a non-destructive scrollback: reads advance a cursor
    but don't free bytes (the oldest are dropped only when the ring is full),
    and a DTR rising edge rewinds the cursor so the full retained history
    replays to whoever just opened the terminal. TX_RING keeps its
    destructive drop-on-full for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
    [peer_log.rs]
2026-06-06 feat(debug): log boot stages by name
    diag_led(N) now logs each boot stage as `boot: stage=N <Name>` (e.g.
    `stage=5 RustInit`) instead of a bare event number, so the boot timeline
    is readable and the last logged stage shows how far boot got. Adds
    DiagEvent::name(). dh_debug only; LED playback behavior is unchanged.
2026-06-06 feat(boot): non-blocking timer-driven boot-stage LED
    diag_led busy-waited the blink pattern, blocking Core0 — and the main
    loop / tud_task — for ~3.9s during initial_setup (measured: each stage's
    log timestamp matched its pattern duration to the ms; the main loop
    started at 4.5s). That directly stalled USB enumeration, since the device
    pulls up at tud_init (~3.0s) but cannot answer SETUP packets until
    tud_task runs.
    Drive the boot-stage LED from a Core0 hardware repeating timer (100ms)
    instead: diag_led just sets the blink count and returns, so setup runs
    unblocked. Blink count == stage number; a boot hang keeps the timer
    blinking the last stage for diagnosis. Because it no longer block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
    [boot_led.rs, callbacks.rs, device.rs, hal_shim.c, lib.rs, mod.rs, tasks.rs]
2026-06-06 feat(debug): rate-limited wheel/thumbwheel stream summary
    The vertical HiResWheel and horizontal thumbwheel HID++ streams were
    fully suppressed in the [pt] trace (logging every event floods the
    peer_log ring), so there was no way to see scroll/thumbwheel activity or
    values — which is needed to scope HID++->key remapping (e.g. the MX
    thumbwheel/buttons).
    Accumulate each stream's delta + event count and flush at most once per
    300ms as `[pt] scroll n=<count> sum=<delta>` / `[pt] thumb ...` (signed,
    decimal). Discrete key events still log immediately. DH_DEBUG only; adds
    PassthroughState::dbg_stream accumulators.
2026-06-06 feat(debug): optional pointer-stream summary via "ptr" CDC command
    Pointer movement is the noisiest stream, so it stays off by default and
    is toggled at runtime by typing "ptr" on the debug CDC. When on, the
    12-bit packed X/Y deltas are accumulated and flushed at most once per 1s
    as `[pt] ptr n=<count> dx=<sum> dy=<sum>` (slower than the wheels). The
    toggle logs `[pt] ptr log on/off`.
    usb.c gains a small incremental command matcher helper; the verified
    "logdump" matcher is preserved and "ptr" added alongside. DH_DEBUG only.
2026-06-06 feat(passthrough): remap MX gesture button to Android APP_SWITCH
    The MX gesture/thumb button (HID++ Control-ID 0xC3) isn't a standard
    mouse button, so on the active output it forwards only as raw vendor
    HID++. A host with the Logitech driver interprets it; Android (no driver)
    ignores the vendor interface, so the button is dead there.
    When the ACTIVE output's configured OS is Android, translate the gesture
    button's press into a Consumer Control "AC Select Task/Application" tap
    (usage 0x01A2) -> Linux KEY_APPSELECT -> Android APP_SWITCH (recent-apps
    overview, a single tap opens the persistent overlay). Other OSes are
    unaffected (raw HID++ still forwards). Config OS-aware via the existing
    per-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
2026-06-06 feat(debug): dump loaded config at boot
    Logs the flash config right after load (rust_init_config, after
    peer_log_init) so settings are visible without guessing — most usefully
    the per-output OS, which gates OS-aware behavior (key_remap, the new
    gesture-button->APP_SWITCH remap). Emits `[x] cfg ver/role/active/pt/gm/
    ss_ms` and `[x] cfg out0 os out1 os (legend)`. DH_DEBUG only.
    Helps diagnose the gesture remap not firing: it requires the active
    output's os == Android (4).
2026-06-06 feat(debug): log hotkey actions and config-mode state
    To diagnose config-mode entry (the gesture-remap test needs the config
    tool to set output OS=Android), make the path observable:
    - execute_action logs `[hk] action=<Name>` for every fired hotkey, so a
    ConfigEnable press is visible (and confirms the dongle keyboard reaches
    hotkey detection, not just raw passthrough).
    - the boot config dump adds `cfgmode=<0|1>`, so a reboot into config mode
    (ConfigEnable sets a watchdog scratch flag and reboots) is confirmable.
    Adds HotkeyAction::name(). DH_DEBUG only.
    [callbacks.rs, hotkey_dispatch.rs, keyboard.rs]
2026-06-06 fix(config): arm watchdog on config-mode entry so the reset fires in debug
    Config-mode entry is driven by starving the watchdog: prepare_config_mode
    sets the scratch flag + reboot_requested, check_system_health then stops
    kicking, and the watchdog-timeout reset (which preserves the scratch
    flag, unlike a bare AIRCR reset) reboots into config mode.
    Debug builds boot with the watchdog disabled (it was disabled so the long
    boot-LED blinks didn't trip it — now moot since the boot LED is
    non-blocking). With no watchdog running, starving it does nothing: the
    reboot never happens, so config mode (and its USB mass-storage config
    drive) can't be entered in debug builds. The hotkey fired
    (`hk actio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
    [device.rs, hal_shim.c, hotkey_dispatch.rs, mock.rs, pico.rs, traits.rs]
2026-06-06 feat(debug): log config SET/SAVE operations
    Make the config protocol observable so "settings don't save" can be
    diagnosed: handle_api_msg logs `[cfg] set idx=N v=0xVV` on every SetVal
    (and a READONLY note if the field is read-only), and the SaveConfig
    dispatch logs `[cfg] save`. GET/read-all stays silent to avoid flooding
    on page load.
    In config mode the board is a mass-storage device with no CDC, so these
    lines reach the peer board's CDC over the UART log forward. DH_DEBUG only.
    [config_api.rs, packet_dispatch.rs]
2026-06-06 fix(config): write the value, not the field index, on a config SET
    handle_api_msg passed the whole packet payload to write_field, but the
    SET wire format is data[0]=field index, data[1..]=value. write_field
    reads its value from offset 0, so every SET wrote the field INDEX as the
    value (e.g. setting output[1].os=Android(4) actually stored 46, the
    index). Config changes from the GUI therefore never took effect — the
    "save doesn't work" symptom. The config SET/SAVE logging made it obvious:
    `set idx=46 v=0x2e`, `idx=77 v=0x4d` — value == index for every field.
    Pass &data[1..] to write_field. Fixes the existing set-val test (it had
    encoded the bug by putting the value at offset 0) and adds a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
    [config_api.rs]
2026-06-06 fix(config): checksum must exclude trailing struct padding
    validate_config and compute_config_checksum took the CRC over
    config_bytes[..size_of::<Config>() - 4], assuming `checksum` is the final
    4 bytes. But Config has u64 members, so it is 8-byte aligned and the
    trailing u32 `checksum` is followed by 4 bytes of padding — checksum sits
    at size-8, not size-4. The CRC therefore covered the checksum field
    itself, so a freshly saved config's stored checksum never equaled the
    recomputed one. validate_config always failed and load_config fell back
    to DEFAULT_CONFIG on every boot: config changes (e.g. output OS) never
    persisted regardless of the GUI. Combined with the earlier SET off-by-one,
    the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
    [config.rs, config_api.rs]
2026-06-06 feat(config): default output OS A=Windows, B=Android
    DEFAULT_CONFIG previously defaulted output A to macOS and output B to
    Linux. Set A=Windows, B=Android to match the target setup. With the
    checksum-range fix making config persist, this default also means a
    fresh/wiped device has B=Android out of the box, so the HID++ gesture ->
    APP_SWITCH remap (which gates on the active output's os == Android) works
    without a manual config step.
    The C user_config.h OUTPUT_*_OS macros are vestigial (the real default
    lives in Rust DEFAULT_CONFIG); updated them to match and noted the source
    of truth.
    [config.rs, user_config.h]
2026-06-06 feat(debug): CDC commands to inject consumer/keyboard codes to active output
    To hunt the right Android key for the gesture remap (0x1A2 turned out to
    open the app drawer, not the recent-apps switcher) without reflashing per
    candidate, the debug CDC now takes newline-terminated commands dispatched
    in Rust (rust_dbg_cmd):
    logdump — replay the scrollback
    ptr — toggle pointer-stream logging
    cc<hex> — Consumer Control tap to the active output (e.g. cc1a3)
    kb<modkey-hex> — keyboard tap, hi byte = modifier, lo = keycode
    (e.g. kb042b = LeftAlt+Tab)
    usb.c's per-command incremental matchers are replaced by a small line
    buffer feeding rust_db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
    [callbacks.rs, usb.c]
2026-06-06 feat(passthrough): gesture button -> Alt+Tab hold (Android recent apps)
    HW testing showed the Consumer task codes do nothing on the target
    Android and AC Select Task/Application (0x1A2) opens the app drawer, not
    the recent-apps switcher. Alt+Tab is what invokes the switcher there.
    Remap the MX gesture button (CID 0xC3) to Alt+Tab with HOLD semantics on
    an Android active output: press opens the switcher (Tab tap) and holds
    LeftAlt so the overlay stays; release drops Alt and commits the
    highlighted app (or whatever was touch-selected). on_hidpp_event now
    reports the press/release edge (GestureEdge) instead of a one-shot
    consumer usage, and the remap emits keyboard reports via route_kbd.
    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
2026-06-06 feat(passthrough): gesture button tap=Alt+Tab, hold=app drawer (Android)
    The Alt+Tab-hold switcher worked but its UX was poor: holding the gesture
    button puts the MX into gesture mode and withholds pointer motion (it is
    diverted to ReprogControls raw-XY, fn=1), so the overlay could only be
    scrubbed by swiping Tab/Shift+Tab — awkward and slow. HW capture confirmed
    the raw-XY stream (long report, big-endian dx@[4..6], dy@[6..8]) and that
    scrubbing stepped correctly, but the interaction was not worth keeping.
    Replace it with a press-duration split, decided on release so a long press
    never flashes the switcher:
    - tap (< HOLD_THRESHOLD_US): one-shot Alt+Tab, toggles to the previous app.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
    [hidpp_keymap.rs, passthrough.rs, passthrough_service.rs]
2026-06-06 docs: development & debug tooling reference
    Document the debug-only surface so it is discoverable without reading the
    source: the DH_DEBUG / DH_DEBUG_CDC_FLASH build flags, the dlog line format
    and subsystem tags, the peer_log scrollback + how to capture it (DTR-edge
    replay / logdump, dual-board UART forwarding), the high-frequency stream
    summaries, the line-based CDC commands (logdump, ptr, cc<hex>, kb<hex>,
    flash), and the two independent version schemes (firmware metadata + peer
    auto-propagation, and the magic/version/CRC config validation with no
    migration).
    Link to it from the README's CDC Flash section.
2026-06-06 feat(debug): log heartbeat firmware version/crc exchange (on change)
    Board-to-board firmware auto-propagation (ADR 0003) was invisible. Log the
    peer-vs-self firmware version/crc exchange and the upgrade decision so it can be
    diagnosed — this already exposed a stale board reporting version=0 (its
    _running_fw was never populated), which is why a sync never triggered.
    The log lives in the service layer (packet_dispatch::log_fw_heartbeat), keeping
    the pure msg_handlers handler untouched, and fires ONLY when the peer's reported
    version/crc or the upgrade decision changes — steady-state agreement (~1 Hz) is
    silent so it never floods the ring. On a board's CDC the "peer" fields are the
    OTHER b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
2026-06-06 feat(debug): log firmware transfer progress, abort, and end
    The multi-second board-to-board flash transfer was invisible. Add three
    observability points in the transfer path (subsys 'fw'):
    - rx abort (Error): out-of-sequence word -> log got/want before resetting.
    - rx progress (Info): one line per 4KB boundary (64 for a 256KB image),
    piggybacking the existing LED-toggle gate so the hot per-word path is untouched.
    - tx end (Info): peer requested past the image end -> the natural transfer
    terminator / source-reached-end marker.
    [fw_upgrade.rs]
2026-06-06 fix(bootloader): halt Core1 before reset_usb_boot; centralize the reset path
    Programmatic entry into the UF2 bootloader (CDC "flash" command, fw-upgrade ROM
    recovery, local UF2 write recovery) was unreliable on this dual-core board:
    reset_usb_boot was issued from Core0 while Core1 kept driving the PIO-USB host,
    so the bootrom could not cleanly bring up the RPI-RP2 mass-storage device — the
    chip reset back into firmware, hung dark, or froze.
    Add a single dh_enter_bootloader() helper that multicore_reset_core1() before
    reset_usb_boot(), and route all four reset-to-bootloader sites through it
    (previously bare reset_usb_boot calls with inconsistent args, one of them from
    inside the tud_cdc_rx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
    [hal_shim.c, ramdisk.c, setup.h, tasks.c, usb.c]
2026-06-06 fix(flash): park Core0 during fw-upgrade flash writes (dual-core hazard)
    The fw-upgrade receiver writes flash from Core1 (firmware_upgrade_task). During
    flash_range_program/erase the XIP interface is offline, so Core0 must not execute
    from flash or it faults/hangs — this was the auto-sync freeze (the path was never
    exercised before because a stale board reported version 0, so the upgrade never
    triggered).
    Arm Core0 as a multicore-lockout victim at boot (setup.c) and have write_flash_page
    park Core0 around the flash op when called from Core1 (hal_util.c). Config save runs
    on Core0 (single page) and is left as-is. No SIO-FIFO conflict (lockout uses it; the
    firmware does not).
    HW-verified: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
    [hal_util.c, setup.c]
2026-06-06 feat(debug): boot firmware/config version banner
    Log a one-time `[boot] fw ver=.. crc=.. cfgver=.. role=.. dbg=..` line at the
    start of the Core0 main loop, where _running_fw is already populated (unlike the
    earlier rust_init_config config dump). Makes each board's firmware identity
    visible in the debug log without a heartbeat exchange.
2026-06-06 refactor(fw-upgrade): unit-tested Rust step machine + correct completion
    The per-tick receiver logic (page-write trigger, page-address (addr-1)&~0xFF,
    sector-erase, terminal condition) lived in C (firmware_upgrade_task_c) with zero
    unit-test coverage — which is exactly how the terminal off-by-one shipped (a `>`
    that never fired because the address caps at the image size, so the upgrade
    never completed and re-requested the out-of-range byte forever).
    Extract it to a pure, #[repr(C)] Rust function fw_upgrade::next_step(address)
    -> FwStep, consumed by the C task via rust_fw_next_step. The C side now only
    performs the flash/SDK side-effects. next_step fixes two bugs and is unit-tested:
    - term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
    [flash.h, fw_upgrade.rs, tasks.c]
2026-06-06 fix(fw-upgrade): only clear byte_done when the REQUEST is enqueued
    request_byte cleared byte_done and then ignored queue_try_add's result. If the
    tx queue was transiently full (it is shared with the peer-log forwarder,
    passthrough host-tx, and heartbeat producers on Core1), the REQUEST was dropped
    but byte_done stayed false — the receiver then waits forever for a response to a
    request that never went out, wedging the upgrade with no timeout or retry.
    Clear byte_done only on a successful enqueue; a failed enqueue becomes a no-op
    retried on the next tick.
    [tasks.c]
2026-06-06 build(fw-upgrade): link pico_flash; arm Core0 via flash_safe_execute_core_init
    Prep for the staging-promote: link pico_flash (and hardware_exception, which the
    bundled minimal SDK's pico_flash does not declare as a dependency) and replace
    Core0's multicore_lockout_victim_init() with flash_safe_execute_core_init().
    flash_safe_execute_core_init() calls multicore_lockout_victim_init() internally
    (so write_flash_page's manual per-page lockout still parks Core0) AND registers
    the flash-safety helper so flash_safe_execute() can run the RAM-resident
    STAGING->RUNNING promote with the other core safely parked. No runtime behavior
    change yet.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
    [setup.c]
2026-06-06 feat(fw-upgrade): stage to STAGING slot + SRAM-resident promote (no-brick transfer)
    Replace the in-place upgrade (which overwrote the running image as bytes arrived
    and "worked" only because the propagated image happened to be code-compatible at
    the same addresses — fragile, and any transfer failure left a half-written
    running image / silent brick) with a staging A/B scheme:
    - RECEIVE into ADDR_FW_STAGING, never the running slot. RUNNING stays intact and
    bootable for the entire transfer, so a dropped packet / abort / stall / power
    loss during transfer needs NO recovery — just clear the upgrade and let the
    peer re-trigger on the next heartbeat. No in-place corruption, no forced
    b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
    [firmware.h, hal_util.c, tasks.c]
2026-06-06 fix(config-mode): clear both scratch words when consuming the config-mode flag
    is_config_mode_active() checks scratch[5]==MAGIC_WORD_1 && scratch[6]==MAGIC_WORD_2
    but cleared only scratch[5] on a match, leaving a live MAGIC_WORD_2 in a
    reset-surviving watchdog scratch register. Clear both so the persistent flag is
    fully reset and can't spuriously re-arm config mode.
    [setup.c]
2026-06-06 fix(fw-upgrade): reboot the staging promote via watchdog reset, not SCB AIRCR
    The SRAM promote ended with an inline SCB AIRCR SYSRESETREQ to boot the new
    image, but on RP2040 that did NOT reboot — it left the board hung (frozen until
    a manual power-cycle, after which it booted the correctly-copied new image).
    AIRCR does not re-run the bootrom the way a watchdog reset does.
    Replace it with an inline watchdog reset: scratch[4]=0 (bootrom does a normal
    flash boot) + WATCHDOG_CTRL TRIGGER (immediate reset). Inline register writes
    only (no flash-resident call like watchdog_reboot(), which could be at a
    different address in the just-written image) so it stays RAM-safe. Verified the
    promote call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
    [hal_util.c]
2026-06-06 chore: bump DDM version to 2
    Bump DDM_VERSION (the fork's revision), not VERSION_MINOR — 0.77 tracks the
    upstream DeskHop release, so the semi-DDM auto-sync/staging work belongs in the
    DDM rev. FIRMWARE_VERSION becomes 17702 ((MAJOR*1000+MINOR+100)*100+DDM), which
    also drives the version-based board-to-board auto-sync.
2026-06-06 fix(fw-metadata): align crc32.py packing to firmware_metadata_t (checksum offset)
    crc32.py packed the metadata as '<IHI' (magic, version, crc32 — no padding), but
    the C firmware_metadata_t { uint32 magic; uint16 version; uint32 checksum; } has
    uint32 alignment, so `checksum` sits at offset 8 (2 bytes of padding after the
    u16 version). The firmware therefore read `checksum` from the wrong offset — it
    picked up the high half of the crc32 plus padding instead of the real value, so
    the version/crc the heartbeat reports and the auto-sync compares was not the
    actual image CRC32 (the version field, at offset 4, was unaffected).
    Pack '<IHxxI' to insert the 2 padding bytes so the crc32 lands at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
2026-06-06 feat(debug): add 'pushfw' CDC command to force peer firmware sync
    Board-to-board auto-sync only flows newer->older: a board pulls when the
    peer's heartbeat reports a higher version. When both boards sit at the same
    or a higher version than a freshly-built image (common in dev), auto-sync
    never fires and there is no way to push a build across without USB-flashing
    each board.
    `pushfw` works around this. The board it is typed on emits one heartbeat
    reporting a sentinel version of 0xFFFF (the u16 max, always greater than any
    real version). The peer's should_start_fw_upgrade accepts it as "newer" and
    starts an auto-sync, pulling this board's REAL running image (the byte
    server streams real flash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
2026-06-06 test(fw-upgrade): strengthen auto-sync unit coverage
    Add the unit tests the audit found absent across the auto-sync pure
    functions (host target; the default thumbv6m-none-eabi has no test crate):
    - receive_fw_byte CRC lower-edge (addr SIZE-SECTOR-4 still accumulates) +
    a word-stream-vs-flat calc_crc32 cross-check that locks the source<->
    receiver little-endian byte-order contract.
    - page_buffer placement at an intra-page offset and at the last word of a
    page (pins the `offset + 4 <= len()` upper-bound guard).
    - send_fw_byte ResponseByte layout: little-endian address echo + served
    word == read_running_fw().to_le_bytes() (MockHal gains a settable
    running_fw word; default 0 keeps exi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
    [actions.rs, crc.rs, fw_upgrade.rs, mock.rs]
2026-06-06 refactor(heartbeat): share build_heartbeat_payload between sender and pushfw
    heartbeat_tick and the pushfw dev command (dbg_force_push) each hand-built
    the 8-byte Heartbeat payload [ver_lo, ver_hi, crc_lo, crc_hi, output, ...].
    Two independent copies of the same byte layout can drift into a version/
    crc/output slot transposition. Extract a single build_heartbeat_payload()
    in domain/packet.rs and call it from both producers.
    Behavior is identical: the existing heartbeat_sends_packet wire-byte test
    plus two new payload tests (normal + pushfw 0xFFFF sentinel preserving the
    real crc16) pin the layout. 534 tests pass.
    [callbacks.rs, packet.rs, tasks.rs]
2026-06-06 docs(fw-upgrade): document the board-to-board auto-sync protocol
    Add docs/firmware-auto-sync.md: a code-grounded spec of the auto-sync
    protocol — flash slots (RUNNING/STAGING, metadata sector), packet layouts
    (Heartbeat/RequestByte/ResponseByte), the version-direction trigger rule,
    the receiver state machine (next_step + receive_fw_byte) with the source
    terminal symmetry and byte_done backpressure loop, the CRC contract (the
    three sites that must agree, binascii.crc32 == calc_crc32), the SRAM-
    resident promote invariants, recovery/safety (staging keeps RUNNING
    bootable; no retry by design — BOOTSEL fall-back), observability, the
    pushfw dev command, and known limitations.
    Also fix three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
    [hal_util.c]
2026-06-06 fix(build): isolate dh_debug/release Rust libs in per-feature target dirs
    The dh_debug and release firmware link different Rust libs (the `dh_debug`
    feature toggles debug_log_flush_task & the peer-log CDC path), but cargo's
    output filename is feature-independent and CMake doesn't track the feature
    dimension. A single shared target dir let a debug and a release build
    clobber each other's libdeskhop_rust.a and silently link the wrong one — a
    release build linked the stale dh_debug lib and failed with `undefined
    reference to peer_log_cdc_write_avail`, recoverable only by manually
    deleting the .a.
    Give each feature set its own cargo --target-dir (cmake-dhdebug /
    cmake-release, both under the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
2026-06-06 feat(fw): log firmware-upgrade CRC verify and promote outcomes
    The two firmware-image verify paths failed silently, costing a debugging
    round-trip each time a board got stuck:
    - USB UF2 flash (ramdisk.c): a CRC mismatch erased boot2 and dropped to
    BOOTSEL with no clue why. Now logs upload start, and on the final block
    logs the want-vs-got CRC before erase+bootloader (or the ok crc before
    reboot).
    - Board-to-board auto-sync (tasks.c): a staging CRC mismatch left RUNNING
    intact and silently re-downloaded forever; a promote that returned meant
    the other core could not be parked. Both now log the outcome (ok/promote,
    crc FAIL/retry, promote FAILED/lockout).
    All via dh_debug_printf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
    [ramdisk.c, tasks.c]
2026-06-06 feat(log): surface dropped UART packets and unknown config fields
    The inter-board link silently swallowed every bad packet and the config
    API silently ignored every unmapped field index — both cost a round-trip
    to even notice.
    - packet_dispatch: log drops by reason, throttled so neither a noisy link
    nor a stuck type floods the ring. BadChecksum logs a running count (1st
    then every 64th) so a clean link is silent and a flaky one shows a
    climbing `drop badcrc n=`; UnknownType logs `drop type=0x` only when the
    offending ptype changes. New `pkt` tag (documented in docs/debugging.md).
    - config_api: warn `idx=N unknown field` on an unmapped GET/SET index
    (malformed request, or a confi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
    [config_api.rs, packet_dispatch.rs]
2026-06-06 feat(log): log core1 stall and config-mode idle-timeout reboot
    Two silent reboot/stall causes that read as mysterious hangs:
    - check_system_health: when Core1 stops passing its loop checkpoint, the
    health task stops kicking the watchdog (release resets; debug, with the
    watchdog off, limps on with a dead Core1 and no trace). Now logs
    `core1 STALL ms=N` once, latched, resetting when Core1 recovers.
    - heartbeat_tick: the config-mode idle timeout reboots the board; without a
    line it looks like config mode "won't exit". Now logs before the reboot.
    [tasks.rs]
2026-06-06 feat(log): HID mount completion, config rx validation, CDC command errors
    Three silent spots in the USB/CDC FFI layer:
    - rust_on_hid_mount: log mount completion (addr/inst/proto) — the open
    bracket to the existing `hid umount` close, so an enumeration that mounts
    but never delivers reports is distinguishable from one that never mounted.
    - rust_on_tud_set_report: warn on a config vendor report with a bad length
    or bad checksum (the host config tool otherwise just times out).
    - rust_dbg_cmd: feed back `cc:/kb: bad hex` and `unknown cmd` instead of
    silently dropping a mistyped CDC command (whole-line dispatch, not per
    keystroke, so no flood).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
    [callbacks.rs]
2026-06-07 refactor(usb): move string descriptor assembly to Rust
    The device, configuration and HID-report descriptors are already built in
    Rust (rust_get_*_descriptor); the string descriptor was the lone holdout
    still hand-assembled in C. Port tud_descriptor_string_cb's ASCII->UTF-16
    conversion, 31-char cap and header packing into rust_get_string_descriptor,
    leaving C as a one-line delegate.
    The chip unique board id (USB serial) stays SDK-owned behind a thin
    hal_get_board_id_str wrapper. The STRID_* enum is retained because the
    configuration descriptors reference it.
2026-06-07 refactor(fw): move USB-MSC UF2 write arithmetic to Rust
    The config-mode drag-and-drop upgrade path (tud_msc_write10_cb) hand-rolled
    the same off-by-one-prone block arithmetic the UART auto-sync path keeps in
    the unit-tested Rust step machine (next_step): final-block detection, the
    per-page flash address, and the CRC-coverage gate that excludes the metadata
    sector. Extract those decisions into msc_write_step (+ rust_msc_write_step,
    MscStep #[repr(C)]) with 5 unit tests, including the one-block-short final
    case the C had no coverage for.
    C now only does the flash side-effects and the post-write CRC verify (which
    must read freshly-written flash). Behavior is unchanged; the arithmetic is
    now te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
    [flash.h, fw_upgrade.rs, ramdisk.c]
2026-06-07 refactor(uart): own the RX ring read cursor + packet fetch in Rust
    The DMA RX ring math — read cursor, START1/START2 preamble scan, fixed-length
    fetch with preamble strip — lived behind five thin C helpers in hal_shim.c
    (hal_is_start_of_packet, hal_fetch_packet, hal_dma_advance_one,
    hal_dma_read_pos, hal_get_in_packet_ptr) over global_hw.dma_ptr/in_packet,
    while packet_receive_tick already drove the loop from Rust.
    Move that math into the PicoHal DmaRx impl: Rust reads uart_rxbuf via an
    extern static and owns the read cursor + fetched-packet buffer as statics.
    The five C helpers and their FFI decls are deleted; only the DMA write
    position (hal_dma_rx_remaining) stays a hardware call. Th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
    [device.rs, hal_shim.c, pico.rs]
2026-06-07 refactor(usb): assemble passthrough config descriptor in Rust
    hal_passthrough_build_config_desc hand-assembled the Semi-DDM composite
    configuration descriptor in C: config header, two DeskHop base HID interfaces,
    one HID interface per captured passthrough interface, and (DH_DEBUG) a CDC
    debug interface — with the CFG_TUD_HID brick-guard, interface/endpoint
    numbering, overflow checks and wTotalLength backfill all in untested C.
    Move the assembly into domain::usb_config_desc::build_config_desc, a pure
    unit-tested function: the TUD_HID_DESCRIPTOR / TUD_CDC_DESCRIPTOR byte layouts
    are re-encoded as const arrays and the arithmetic (the brick-guard especially)
    is covered by 6 tests asserting th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
2026-06-07 refactor(uart): read the DMA RX ring via read_volatile
    The RX ring (uart_rxbuf) is written asynchronously by DMA, so Rust must read
    it through a `static mut` + `read_volatile` rather than an immutable `static`
    with a plain load: an immutable static lets the optimizer treat the bytes as
    invariant and cache/elide the reads. On thumbv6m today both lower to the same
    `ldrb` (the binary is byte-identical, HW auto-sync verified working), so this
    is purely defensive — it pins the correct DMA-memory access idiom so a future
    codegen change can't silently break packet reception (an HW-only failure mode
    that unit tests, which use MockHal, cannot catch).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
    [pico.rs]
2026-06-07 chore(gitignore): whitelist shared .claude project assets
    Switch .claude/ from a blanket ignore to ignore-everything-then-allow so
    project-scoped assets (skills, commands, agents, shared settings.json) can be
    tracked while personal/local state (settings.local.json, plans/, worktrees/)
    stays ignored. Needed so the project release skill can live in-repo.
2026-06-07 chore(skill): add DeskHop firmware release skill
    Project-local skill that cuts a release from the rust-port line: bump
    DDM_VERSION + commit/push, release-build the UF2 in build-release/, verify the
    decoded tag and the 262144-byte image, generate changelog notes from the commit
    log since the previous tag (escalating to --stat/diff when subjects are thin),
    and publish the GitHub release with the UF2 attached. Includes a body template
    matching the existing release-note style.
2026-06-16 fix(passthrough): require a release between SmartShift presses to switch
    The double-click -> output switch fired on any second SmartShift "Down"
    within the window without checking that a release (Up1) occurred in
    between. Branch (b) set switch_requested on the first is_smartshift_press
    seen after the window opened, so press->press was treated as a double-click.
    This stayed latent until c4224bb added fn=0 divertedButtons detection next
    to the existing fn=2 path: a single physical wheel-mode click can surface
    as two "Down" reports (dual fn=2+fn=0 emission, or a held divertedButtons
    bitmap re-sent), which press->press logic counted as a double-click and
    switched on a single click.
    Gate the sw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
    [passthrough.rs, passthrough_service.rs]
2026-06-16 fix(passthrough): learn ReprogControls index from fn=0 so the gesture remap fires
    The Android gesture/thumb-button remap (tap=Alt+Tab, hold=app drawer) needs
    fi_reprog_controls to tell its divertedButtonsEvent apart from the scroll
    streams. That index was learned ONLY by autolearn_feature from an fn=2
    analyticsKeyEvent, and only on the inactive-output convert path. A mouse whose
    buttons Options+ diverts as fn=0 divertedButtonsEvents (the common case — the
    same shape c4224bb added for SmartShift) never emits fn=2, so fi_reprog_controls
    stayed 0 and the remap silently no-opped, even with Options+ present and the
    button correctly diverted. (SmartShift worked regardless because its detection
    s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
    [hidpp_keymap.rs, passthrough.rs, passthrough_service.rs]
2026-08-30 fix(hid): stream descriptor parsing to fit Core1's 2KB stack
    parse_report_descriptor built ~7KB of ParseResults+ParserState by value,
    producing a measured 14,348-byte stack frame. It runs inside the TinyUSB
    mount callback on Core1, whose stack is the SDK-default 2KB, so every HID
    device enumeration silently overran the stack by ~12KB into adjacent RAM.
    Rework the parser around a streaming core (parse_descriptor_with) that
    hands each parsed INPUT item to a callback, with handle_main_input writing
    into a caller-provided out-param instead of returning by value. The FFI
    wrapper keeps its ~850B ParserState in a Core1-only static and consumes
    items as they are produced. The accumulating parse_des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
    [callbacks.rs, hid_parser.rs]
2026-08-30 fix(debug): shrink dh_debug_printf stack frame for Core1 callers
    dh_debug_printf kept a 512B format buffer plus a 1024B CRLF-conversion
    copy on the stack (~1.5KB frame). Rust traceln on Core1 routes here via
    hal_trace_write, and Core1's stack is only 2KB, so every debug log line
    from the USB-host core ran within a few hundred bytes of overflow.
    Format into a single 256B buffer and stream the CRLF conversion as
    peer_log_push runs (push up to each bare \n, then "\r\n") instead of
    building a converted copy. Measured frame: ~1,548B -> ~290B.
    Claude-Session: https://claude.ai/code/session_01587EUHZfTSvnZdLVbDsd7Q
    [hal_util.c]
2026-08-30 fix(hid): drop zero-length reports before report-ID dispatch
    TinyUSB's hidh_xfer_cb delivers len==0 to tuh_hid_report_received_cb for
    failed/ZLP transfers, and neither usb.c nor the Rust entry filtered it.
    The report-ID dispatch (*report) and the mouse extract path (report[0])
    then index an empty slice: the resulting panic lands in the diag_led busy
    loop, which never feeds the 500ms watchdog, so one bad transfer rebooted
    the whole KVM.
    Guard at rust_on_hid_report_received (covers every handler and the
    passthrough forward) and defensively in process_mouse_report, whose
    exported symbol can be called without going through the entry guard.
    Not host-testable: the FFI entry reads C globals (Devi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
    [callbacks.rs]
2026-08-30 fix(fw-sync): recover the lock-step transfer from a lost packet
    The firmware auto-sync is strictly lock-step: the receiver requests one
    word and acts only when the matching ResponseByte arrives. One packet
    lost to the UART checksum gate (~65k round trips per 256KB image) left
    byte_done false forever — nothing re-requested, no timeout existed, and
    heartbeat_tick is silenced while upgrade_in_progress, so the board sat
    wedged and heartbeat-silent until power-cycle (the field-observed
    "board B stalled mid-sync" failures).
    Add a stall tracker (service::fw_upgrade::stall_tick, unit-tested): while
    waiting on a ResponseByte, re-send the RequestByte for the current
    address after 250ms, and after 2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
    [flash.h, fw_upgrade.rs, tasks.c, tasks.rs]
2026-08-30 fix(fw-sync): set PSM WDSEL before the promote watchdog reset
    The staging promote reboots via WATCHDOG_CTRL_TRIGGER, but the reset
    scope (PSM WDSEL) is configured only by the SDK's _watchdog_enable(),
    which DH_DEBUG builds never call (watchdog is disabled for debugging).
    With WDSEL=0 the trigger resets nothing, so every debug-build promote
    finished the copy and then spun forever in the tail loop with interrupts
    off — the reproducible "board B silent after auto-sync" freeze that
    docs/CLAUDE.local.md had recorded as a transient. Release builds were
    unaffected (watchdog_enable at boot sets WDSEL).
    Select everything but ROSC/XOSC, exactly as _watchdog_enable does, with
    a direct register store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
    [hal_util.c]
2026-08-30 fix(hid): drop a stalled hid_queue_out head instead of jamming forever
    process_hid_queue only peeked the head and returned when its HID instance
    was not ready, but a passthrough entry's dev_inst can never become ready
    again after an unplug: the disconnect/reconnect re-enumeration resets to
    the default 2-interface descriptor and hidd_reset zeroes _hidd_itf, so
    tud_hid_n_ready(stale_inst) stays false forever. Every consumer-control
    forward, system-control report, and config-mode response then queued
    behind the stuck head until power-cycle.
    Track how long the current head has been unsendable and pop it after
    250ms of continuous not-ready — long enough for a transiently busy
    endpoint, short e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
    [mock.rs, tasks.rs]
2026-08-30 fix(kbd): honor the NKRO bitmap's mid-byte bit offset
    extract_kbd_nkro advanced to the bitmap's byte index but passed a
    hardcoded bit offset of 0 to extract_bit_variable; C computed
    kbd->offset & 7. A descriptor whose NKRO key bitmap starts mid-byte
    (modifiers plus padding/LED bits before it) reported every usage
    shifted by offset%8 — pressing key N emitted key N-(offset%8).
    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
    [kbd_extract.rs]
2026-08-30 fix(kbd): fall back to boot/other extraction when NKRO extraction fails
    The C original fell through to the boot/other extractors when NKRO
    extraction returned an error, with a comment naming wireless dongles
    that advertise an NKRO collection but transmit boot-style reports. The
    port returned the error directly, and the caller discards the rc and
    processes the zeroed report — such keyboards produced no keystrokes at
    all. Restore the fallthrough, clearing any partial write first.
    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
    [kbd_extract.rs]
2026-08-30 fix(remap): serialize REMAP_ENGINE access to Core1
    remap_engine_process runs in the TinyUSB host report callback on Core1
    while remap_engine_tick_task was scheduled on Core0 — two aliased
    &'static mut RemapEngine across cores with no synchronization. The
    engine's u64 timestamps are two 32-bit accesses on Cortex-M0+, so a
    torn read could make the tick see bogus elapsed time (spurious hold
    injection) or lose a tap, on top of the aliasing UB. The static's
    "Core0 only" annotation was wrong.
    Move the tick task to the Core1 scheduler loop: callback and tick then
    run strictly sequentially (no preemption between loop tasks), and the
    only remaining Core0 access is remap_engine_init, which runs bef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
    [lib.rs, tasks.rs]
2026-08-30 fix(led): copy the keyboard-LED byte before the async set_report
    tuh_hid_set_report stores the buffer pointer (usbh _ctrl_xfer.buffer)
    and submits the DATA OUT stage after the caller has returned, but
    sync_indicators/send_kbd_led_report pass the address of a stack-local
    LED byte through send_kbd_leds_xcore — the recycled stack slot's
    contents went to the keyboard: wrong Caps/Num LEDs, and a wrong output
    cue with kbd_led_as_indicator. The deleted C original pointed into a
    persistent global; the port dropped that lifetime guard.
    Copy into a static in the shim, mirroring the passthrough set-report
    shim (hal_tuh_set_report). One buffer suffices: send_kbd_leds_xcore
    already gates every caller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
    [hal_shim.c]
2026-08-30 fix(remap): cancel an in-flight tap-hold when its output is switched away
    The output_mask check skipped a masked-out entry before its release
    handling, so switching the active output while the trigger key was held
    stranded the entry in Waiting/Held: remap_engine_tick ignores the mask
    and ripened the stranded entry, get_active_output then injected the
    hold key into the now-active other output, and back on the original
    output the next press landed in the stale Held branch and the tap
    emitted nothing. Per-output masks are the normal config whenever the
    two outputs' OSes differ.
    On a masked-out entry with non-Idle runtime, cancel it: reset to Idle
    with no tap (emitting into the wrong output wou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
    [key_remap.rs]
2026-08-30 fix(dispatch): reject out-of-range OutputSelect values
    active_output is stored from raw peer-packet data with no 0/1
    validation, while the passthrough HID++ path indexes
    config.output[active_output] without a bounds check — a corrupted
    OutputSelect passing the weak 1-byte checksum panics the firmware on
    the next HID++ event (index OOB -> diag_led spin or watchdog reset
    loop). Every other consumer guards; the write path did not.
    Reject the value at both write sites (handle_simple_msg returns None;
    handle_output_select early-returns) — rejecting beats masking, which
    would turn corruption into a coin-flip output switch.
    Claude-Session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
    [msg_bridge.rs, msg_handlers.rs, packet_dispatch.rs]
2026-08-30 fix(usb): off-by-one bounds check in set_protocol_complete_cb
    idx > MAX_INTERFACES admitted idx == MAX_INTERFACES, indexing one past
    the iface array; the sibling callbacks all use >=.
    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
    [usb.c]
2026-08-30 fix(hal): spin after the AIRCR reboot instead of unreachable_unchecked
    The AIRCR SYSRESETREQ write returns and the reset latches
    asynchronously, and on RP2040 an AIRCR reset can fail outright (the
    documented reason promote_staging_cb uses a watchdog reset instead).
    Execution past device::reboot() is a real path, so the
    unreachable_unchecked was undefined behavior on it. Spin instead; in
    release builds a failed reset ends in a watchdog reset.
    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
    [pico.rs]
2026-08-30 fix(config): drop the aliased &Config view in load_config
    rust_load_config built a &mut [u8] over GLOBAL_CFG.config and passed a
    typed &Config view of the same memory alongside it into
    load_config_from_bytes — simultaneous overlapping &mut and & is
    aliasing UB. Validate from the byte image alone (validate_config_bytes
    decodes magic/version/checksum via offset_of!) so the loader needs only
    the mutable slice.
    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
    [callbacks.rs, config.rs]
2026-08-30 fix(hid): cap the report-value byte loop at 32 accumulated bits
    get_report_value's byte loop shifted the next byte by remaining_bits,
    which reaches 32 for a >32-bit descriptor field — an i32 shift overflow
    (panic under dh_debug's overflow checks, masked garbage in release).
    Stop at 32 bits: only the low 32 bits are representable in the i32
    return anyway, matching the mask.
    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
    [hid_report.rs]
2026-08-30 fix(usb): tolerate a NULL descriptor pointer in rust_on_hid_mount
    from_raw_parts requires a non-null pointer even for length 0, but
    TinyUSB can deliver a NULL report descriptor when the descriptor fetch
    failed. Substitute an empty slice; the parse path already guards null
    separately.
    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
    [callbacks.rs]
2026-08-30 fix(passthrough): stop swallowing host HID++ responses with sw_id 0xF
    Any HID++ report whose sw_id matched HIDPP_SWID_DESKHOP (0xF) was
    consumed unconditionally — even when DeskHop's feature scan was idle —
    so a host driver that happens to use sw_id 0xF never saw its responses.
    Intercept only while the scan is actually awaiting a response
    (QueryIRoot); otherwise the report forwards to the host normally.
    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
    [passthrough_service.rs]
2026-08-30 fix(passthrough): drop oversize HID reports instead of truncating
    hal_queue_hid_report silently clamped >32-byte reports to
    HID_REPORT_DATA_MAX, forwarding a corrupted prefix to the host (e.g. a
    HID++ very-long 64B report). Drop the report instead and log once per
    boot. The slot is not widened: the queue is 128 deep, so +32B per slot
    costs +4KB of heap, which would eat the debug log-ring reserve.
    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
    [hal_shim.c]
2026-08-30 fix(screensaver): guard the cross-core inactivity subtraction
    last_activity is stamped by the other core, and u64 loads tear on
    Cortex-M0+ — a torn read can transiently yield last > now. The plain
    `now - last` then underflows: a panic under dh_debug's overflow checks,
    or an absurd inactivity that spuriously starts the screensaver in
    release. Saturate to zero; the next tick reads a consistent value.
    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
    [tasks.rs]
2026-08-30 fix(ramdisk): reject UF2 blocks with out-of-range blockNo
    A valid-magic UF2 block whose blockNo exceeds the running image size
    produced a flash_offset past the RUNNING slot and was written blindly.
    Gate it in msc_write_step (reject flag) and fail the MSC write with -1,
    mirroring upstream v0.78 (b65e8eb).
    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
    [flash.h, fw_upgrade.rs, ramdisk.c]
2026-08-30 fix(mouse): apply jump threshold only to cross-output switches
    The configured jump_threshold gated every screen switch, including local
    virtual-desktop changes, leaving a dead gap when moving between local
    screens. Compute the threshold per movement direction: non-main local
    screens and main-screen moves away from the border switch with no gap;
    only real cross-PC jumps keep the configured gap. Zero X offset never
    switches. Ports upstream v0.78 (58664dd, 9d161be).
    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
    [integration_tests.rs, mouse.rs, mouse_logic.rs]
2026-08-30 fix(mouse): drop held buttons from macOS desktop-switch nudges
    The relative nudge reports that trigger the macOS desktop-edge switch
    repeated the held button state, which latched the relative HID mouse's
    button down permanently when the user dragged an item across desktops.
    Send them with buttons cleared; the absolute edge report keeps the held
    state so the drag itself survives. Ports upstream v0.78 (58664dd).
    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
2026-08-30 fix(mouse): drop no-change reports from composite keyboards
    Composite keyboards (e.g. QMK) exposing a mouse HID interface send
    zero-movement mouse reports during keyboard events; forwarding them as
    absolute position reports made the pointer jump. Skip the pipeline when
    movement, wheel, pan are zero and buttons match the held state. Ports
    upstream v0.78 (af4d38c).
    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
2026-08-30 fix(led): track accepted keyboard-LED state and re-sync until applied
    tuh_hid_set_report can refuse a transfer (endpoint busy, device gone),
    silently losing the keyboard LED update. Split the LED state into
    desired (per-output host requests) and actual (last state the keyboard
    accepted), record actual only on a successful transfer, and add a 30Hz
    Core1 led_sync_task that re-sends until they converge. Ports upstream
    v0.78 (b65e8eb).
    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
    [callbacks.rs, device.rs, hal_shim.c, led.rs, lib.rs, msg_bridge.rs, msg_handlers.rs, packet_dispatch.rs]
2026-08-30 fix(pio): backport upstream USB RX EOP-detect timing fixes
    Backport the Pico-PIO-USB usb_rx.pio changes shipped in upstream
    DeskHop v0.78 (b65e8eb): tightened EOP detection timing in both eop
    detector variants (delay [1] instead of [2], IRQ trigger moved before
    the pin sample) and start the FS EOP state machine at the wrap target
    (offset) instead of offset+1. Hardware verification required before
    merge — PIO timing change on the USB host port.
    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
