zekaizer/deskhop/(notices)

Notices in the files:
src/include/api_config.h:
This program is free software: you can redistribute it and/or modify
it under the terms of the GNU General Public License as published by
the Free Software Foundation, version 3.
